4106677/pramac-pmd5050s-autostart/enclosure/README.md

# Корпус для друку (ABS)

Корпус для плати v5: **основа + кришка з «юбкою» + червона вставка з логотипом**. Заокруглені кути й фаски, кайма: на верху стінок основи є уступ, а кришка має юбку, що накриває його, тому бокові стінки кришки й основи збігаються врівень. Кріплення на стіну вушками, кришка на 4 гвинтах M3 у латунні вставки, червона вставка **без гвинтів, на клею**. Усі розміри параметричні.

| Файл | Призначення |
|---|---|
| `base.stl`, `lid.stl`, `cover.stl`, `ear.stl` | готові моделі для друку (вухо `ear.stl` друкується **4 рази**, окремо від основи) |
| `fusion_enclosure.py` | **скрипт Fusion**: створює параметричну модель (User Parameters + ескізи з розмірами) |
| `enclosure.py` | той самий корпус на Python (manifold3d), з якого зроблено STL |
| `fusion_pcb_assembly.py` | **скрипт Fusion**: додає в модель плату v5 з компонентами, латунні вставки й гвинти M3 і фарбує все в реальні кольори |
| `pramac-logo-vector.svg`, `svgpath.py` | логотип і невеликий SVG-парсер, що вставляє його в модель вставки |
| `render.py` | прості рендери (`iso_closed.png`, `iso_all.png`, `iso_base.png`, `front.png`) |

## Габарити
- Зовнішні розміри **112,3 × 118,6 × 50,6 мм** (без вух основа 112,3 мм завширшки, із вухами 144,3 мм), кришка 4 мм + юбка 6 мм, вставка 2 мм (врівень з кришкою). Стінки 3 мм, радіус кутів 7 мм, фаска 1,2 мм.
- Усередині плата 93,3 × 82,1 мм на трьох стійках (6 мм) у місцях її отворів М3 і ще на **шести опорних стійках** Ø5 без гвинтів, а також на **вузьких полицях** по краях (див. нижче). Над платою вільно **40 мм** (конденсатори 4700 мкФ мають 36 мм), під платою 6 мм (виводи 3,5 мм).
- Під платою (внизу при настінному положенні) вільна зона **24 мм** для проводів до клем.
- Поля навколо плати 6,5 мм, щоб вмістити стійки кришки по кутах.

## Що в корпусі
- **Вставка без гвинтів і наскрізне вікно:** вирізу в кришці дано сходинку: зверху гніздо під вставку (100,5 × 37,6 мм, глибина 2 мм), нижче **наскрізне вікно**, менше за вставку на 3 мм з кожного боку. Вставка 100 × 37 × 2 мм лягає врівень і **приклеюється до сходинки** по периметру (3 мм завширшки, близько 800 мм² склеювання), зазор 0,25 мм по боках лишає місце для клею. Кришка й вставка друкуються **лицем на столі**. Клеїти зручно, поклавши кришку лицем угору: вставку кладуть у гніздо, на сходинку (зі сторони вікна) наносять краплі ціанакрилату або ацетонового ABS-клею й притискають. По центру вставки знак «небезпечна напруга». Логотип **Pramac** (з SVG, 40 мм заввишки) вирізано на **основній кришці**, по центру вільної ділянки над вставкою.
- **Логотип і знак втоплені на 0,05 мм** (параметр `inlay`), тож їх зручно розмалювати іншим кольором: фарба лягає в заглиблення, зайве знімається з поверхні.
- **Підтримка плати:** плата тримається на 3 гвинтах, тому додано 6 опорних стійок Ø5 мм (у вільних місцях, відстань до виводів і перехідних не менше 5,6 мм), 6 полиць, що заходять під край плати на 1,5 мм і **напрямні ребра** з зазором 0,4 мм до краю плати (піднімаються на 2 мм над платою). Плату просто кладуть у «кишеню», гвинти фіксують її. Полиці й ребра розставлено, щоб не зачіпати жодної площадки.
- **Три овальні отвори під дроти в нижній стінці**, кожен заввишки 8 мм (`wire_slot_h`), із фаскою 1 мм зовні та 0,5 мм усередині:
  - 12 В: J1, J4, J5, завдовжки 37 мм;
  - 230 В: CONTACTOR, 13 мм. Він окремий, щоб розділити 230 В і слаботочку;
  - сигнали: TAHO/REMOTE, 18 мм.

  Отвори стоять на висоті затискачів клем (`wire_slot_z`), тож кожен дріт іде до своєї клеми прямо. У 8 мм проходять два дроти до 4 мм² або 2-жильний кабель діаметром до 7,5 мм. Герметичності немає, як і задумано. `enclosure.py` і STL досі мають старі щілини 22 мм.
- **Шість вентиляційних щілин** 2 × 24 мм у верхній стінці.
- **Чотири знімні вушка** для кріплення на стіну (Ø5,2 мм), **без гвинтів**. Кому не треба, той їх не ставить. Вухо друкується плоско й має язичок у формі **трапеції** (12 мм завдовжки, звужується до кінця), який вставляється збоку у відповідну трапецієвидну виїмку під дном основи. Виїмка звужується трохи сильніше за язичок, тому в кінці він заклинюється (самозатискний клин). Оскільки вуха стоять із двох боків, основа не може зсунутись убік. Ні гвинтів, ні гайок, у порожнині нічого не додано, плату й компоненти вуха не зачіпають.
- Отвору під USB немає.

## Що купити
- 4+3 = **7 латунних вставок M3** (під гарячу вставку): 4 в кутових стійках, 3 у стійках плати (отвір Ø4,2 мм). Опорні стійки без вставок.
- Гвинти M3: плата 3× по 6–8 мм (довші до 9 мм), кришка 4× по 10 мм і довші (утоплені в заглиблення). **Під вставками є вільний канал Ø3,4 мм** до висоти 1,2 мм над стіною: у кутових стійках він завглибшки майже на всю висоту (гвинти кришки можуть бути завдовжки до ~50 мм), у стійках плати під вставкою ще близько 3,8 мм (разом із платою гвинт до ~9 мм). Дно каналу не наскрізне, тому до стіни основа прилягає гладко.
- Клей для вставки: ціанакрилат (для ABS), або ABS-«клей» з ацетону.
- Для кріплення на стіну (якщо потрібні вуха): 4 шурупи/дюбелі під отвір 5,2 мм.

## Друк
- **ABS**, шар 0,2, 4 периметри (1,6 мм), заповнення 25–30 %, підігрів 100 °C+, борт (brim) проти відшарування. Потрібен стіл не менше **150 × 120 мм**.
- **Основа:** дном на стіл (відкритою стороною вгору). Опор не треба: отвори під дроти мають круглий верх 8 мм, вентиляційні щілини вузькі. **Кришка:** лицем (зовнішньою стороною) на стіл, юбка вгору; сходинка під вікном це міст 3 мм над порожнім гніздом, ABS його витримує без опор. **Вухо:** плоско, усе лежить на столі. Спершу надрукуйте одне вухо й приміряйте: якщо сидить надто туго або хитається, змініть `tab_wedge` (0,3 мм за замовчуванням; більше це тугіше) або `tab_gap`. **Вставка:** лицем на стіл.
- **Лого й знак:** заглиблення 0,05 мм тонше за шар друку (0,2 мм), тому на друку воно майже не видно, але відчувається пальцем і працює як обмежувач для фарби. Якщо потрібен виразний контур, збільште `inlay` до 0,2–0,4 мм.
- **Багатокольоровий друк:** основа й кришка білі (або будь-який колір), вставка червона. Для кольорового логотипу без фарби збільште `inlay` до 0,2–0,4 мм і залийте заглиблення іншим кольором.
- Вставки: прогріти паяльником із насадкою до заглиблення врівень, Ø отвору 4,2 мм.

## Fusion
1. UTILITIES → ADD-INS → Scripts and Add-Ins (Shift+S) → «+» → `fusion_enclosure.py` → Run.
2. З'являться тіла **Base, Lid, Cover** і параметри (Modify → Change Parameters): `pcb_w`, `margin_side`, `gutter`, `wall`, `comp_h` та інші. Зміна параметра перебудовує модель по таймлайну.
3. Позиції отворів плати, щілин, опорних стійок і полиць заведені списками `PCB_HOLES`, `WIRE_SLOTS`, `SUPPORTS`, `LEDGES_*` на початку скрипта (координати від лівого/верхнього краю плати). Логотип скрипт бере з `pramac-logo-vector.svg` поруч зі скриптом (розмір `logo_h`, центрується автоматично).
4. Плата й кріплення: у вже побудованій моделі запустіть `fusion_pcb_assembly.py`. Положення плати й отворів він бере з параметрів і ескізів корпусу, а тіла додає групами (Base Feature `PCB asm: …` у таймлайні). У документі Part Design не буває підкомпонентів, тож усе лежить тілами в корені. Повторний запуск замінює ці групи. Кольори:
   - корпус: білий ABS;
   - вставка й логотип: червоні (#C01717);
   - знак на вставці: білий;
   - плата: зелена;
   - реле: сині;
   - клеми: зелені;
   - резистори: кольорові смуги за номіналом;
   - гвинти: нержавійка, ISO 7380 M3×8;
   - вставки: латунні.

   Скрипт моделює плату **v5.1**: ESP32 на 2 мм вище, ніж на v5, а **іоністор SC1** (JEC SMD05R5S0001DARZ, 1 Ф 5,5 В, овал 16 × 8 × 14 мм) стоїть прямо на платі, на власному посадковому місці між ESP32 і реле K1/K2. Зазори близько 1 мм до гнізд ESP32 і до реле. Друкована підставка під іоністор, яка була для v5, більше не потрібна. Опорну стійку під гніздами ESP32 зсунуто в (85, 24), щоб не впиралась у пайку гнізд.

⚠️ Скрипт написано за документацією Fusion API **без запуску у Fusion** (на цьому Mac його нема), STL натомість перевірені. Основна геометрія створюється першою, а косметика (заокруглення кутів, фаски, знаки, логотип з SVG, напрямні ребра) йде як «необов'язкові» кроки: якщо якийсь не вдасться, скрипт піде далі й наприкінці перелічить пропущене. Якщо впаде основний крок, він покаже назву кроку й помилку. Надішліть мені текст, я виправлю. Найризикованіший крок: імпорт SVG (`importSVG`) і відбір контурів букв без «острівців» (внутрішніх частин літер P, R, A). Якщо він не вдасться, перемістіть SVG вручну (Insert → Insert SVG) і вирізайте на 0,05 мм, або використовуйте готовий `cover.stl`.

## Перевірка перед друком
Роздрукуйте `fit_check_1to1.pdf` плати й приміряйте до отворів (3 стійки, відстані до клем). Висоту ESP32 з колодками (~22–25 мм над платою) і конденсаторів 36 мм перевірте реальними деталями: якщо щось вище 40 мм, збільшіть `comp_h`.
