4106677/pramac-pmd5050s-autostart/hardware/v6/README.md

# Плата v6

Плата під заводську збірку JLCPCB (PCBA): майже все SMD, решту (реле, клеми, модуль AC-DC, мережевий запобіжник, варистор) завод теж паяє, сервісом THT. Допаювати нічого не треба.

| Файл | Що це |
|---|---|
| `pramac_v6_schematic.pdf` | схема для перегляду |
| `pramac_v6.kicad_sch`, `pramac_v6.kicad_pro`, `pramac_v6.kicad_sym`, `sym-lib-table` | проєкт KiCad 10 (схема + власні символи CN3767 і AO4421) |
| `pramac_v6_bom.csv` | BOM у форматі JLCPCB (Comment, Designator, Footprint, LCSC) |
| `gen_schematic.py`, `charger.py`, `parts.py`, `kisch.py` | генератор схеми: `python3 gen_schematic.py` |
| `pramac_v6.kicad_pcb`, `pramac_v6.kicad_dru` | плата 125 × 100 мм, 2 шари, і правило зазору 2,5 мм для 230 В |
| `pramac_v6_gerbers.zip` | гербери + свердління для JLCPCB |
| `pramac_v6_bom.csv`, `pramac_v6_cpl.csv` | BOM і файл розміщення (CPL) для заводської збірки |
| `pcb-top.png`, `pcb-bottom.png`, `drc.rpt` | рендери і звіт DRC |
| `gen_pcb.py`, `pramac_v6.dsn`, `pramac_v6.ses` | генератор плати: `gen_pcb.py place` → Freerouting (`.dsn` → `.ses`) → `gen_pcb.py route` → `gen_pcb.py export` |

## Що змінилось порівняно з v5.1
- **ESP32-S3-MINI-1U-N8** розпаяний на платі (15,4 × 15,4 мм), роз'єм U.FL під зовнішню антену: кабель U.FL → SMA на стінці корпусу. Прошивка й лог по USB-C (USB вбудований у чип), кнопки BOOT і RESET.
- **Живлення без іоністора:** два маленькі перетворювачі прямо від АКБ. AP63203 дає 3,3 В для ESP32 і працює від 3,8 В. AP63205 дає окремі 5 В для котушок реле. Обидва мають режим LDO: коли АКБ під час прокрутки падає нижче 5 В, вихід 5 В іде слідом за входом, а реле SRD-05 тримаються аж до ~2 В на котушці. Тому **іоністор більше не потрібен**.
- **Реле** ті самі Songle SRD-05VDC-SL-C. Ключі AO3400A, діоди на котушках, світлодіод стану на кожному реле.
- **Четверте реле K4 AUX** для підігрівача перед пуском або соленоїда декомпресії. COM на шині АКБ, як у ACC і START, вихід на окремий клемник J8 (AUX, GND).
- **Зарядка АКБ від 230 В:** модуль Mean Well IRM-20-24 → зарядник CN3767. Заряд 14,8 В, підтримка 13,55 В (задані всередині мікросхеми), струм 1 А. Підходить для звичайних свинцевих і AGM.
- **Детектор мережі:** оптопара LTV-814 на вході 230 В.
- **DIP-перемикач на 4 позиції** для вибору режиму, **4 кріплення M3 по кутах**, знімні клемники 5,08 мм.

## Живлення
`BATTERY+` → самовідновлюваний запобіжник 2 А (PTC) → `VBF` (TVS SMBJ18A, вихід зарядника, вимір напруги АКБ) → SS54 → `VIN12` (470 мкФ).
Від `VIN12` живляться AP63203 (3,3 В, ESP32) і AP63205 (`V5`, тільки котушки реле й світлодіоди реле).
Від USB: `VBUS` → SS34 → `VIN12`, тобто ESP32 можна прошити без 12 В.
Шина `VBAT` (до запобіжника) іде на COM реле ACC і START. На дроті від АКБ, як і раніше, потрібен зовнішній запобіжник ~15 А.

## Зарядник
- **Живлення і перемикач:** `V24` з модуля через P-MOSFET Q20. Ним керує ESP32 (`CHG_EN`): HIGH, або коли ESP32 не працює, зарядка йде; LOW — вимкнена. Прошивка вимикає зарядку на час прокрутки стартера і коли DIP2 вимкнений.
- **Струм:** 0,12 В / R66 = 1 А при R66 = 0,12 Ом. Модуль на 20 Вт має запас: зарядник бере близько 17 Вт.
- **Захист модуля від перевантаження:** дільник MPPT (150k/10k). Якщо модуль просяде нижче ~19 В, зарядник сам зменшить струм.
- **Стан:** `CHG_STAT` (заряджається) і `CHG_DONE` (заряджено) йдуть на ESP32 і на два світлодіоди.

## Піни ESP32-S3
| GPIO | Сигнал | GPIO | Сигнал |
|---|---|---|---|
| IO1 | напруга АКБ (АЦП, дільник 100k/22k) | IO9 | світлодіод STATUS |
| IO2 | CHG_DONE | IO10 / IO11 / IO12 | реле K1 ACC / K2 START / K3 контактор |
| | | IO21 | реле K4 AUX |
| IO4 | TAHO (LM393) | IO13–IO16 | DIP1–DIP4 |
| IO5 | REMOTE (сухий контакт між двома клемами REMOTE) | IO17, IO18 | резервна гребінка J7 |
| IO6 | MAINS_OK (мережа є = LOW) | IO19 / IO20 | USB D− / D+ |
| IO7 | CHG_EN | IO0 / EN | BOOT / RESET |
| IO8 | CHG_STAT | | |

## DIP-перемикач
1. Режим: OFF — запуск за сигналом REMOTE; ON — запуск, коли пропала мережа.
2. Зарядка дозволена.
3. Затримка запуску: 10 с або 60 с.
4. AUX: OFF — K4 працює як підігрів (вмикається на N секунд до прокрутки), ON — як декомпресія (тримається під час прокрутки).

## Роз'єми (знімні клемники 5,08 мм)
| Роз'єм | Контакти |
|---|---|
| J1 | AC IN: L, N |
| J2 | CONTACTOR: COM, NO (сухі контакти, 230 В) |
| J3 | BATTERY: +, − |
| J4 | ACC, START |
| J5 | TAHO; REMOTE, REMOTE (два контакти під сухий контакт або кнопку, полярність не важлива) |
| J8 | AUX: вихід K4 (+12 В з АКБ), GND |

Плагіни до клемників (WJ2EDGK, 5 × 2P і 1 × 3P) JLCPCB надсилає разом із замовленням окремими деталями.

**Навантаження на AUX.** Контакт реле SRD розрахований на 10 А. Свічки розжарювання і соленоїд декомпресії в момент втягування часто беруть більше. Тому для них ставте зовнішнє автомобільне реле на 30–40 А: його котушку підключити до J8 (AUX і GND), а силові контакти — напряму від АКБ через свій запобіжник. Слабке навантаження до ~8 А можна живити від J8 напряму.

## Плата
- **Розмір і кріплення:** 125 × 100 мм, 2 шари, 4 отвори M3 по кутах (за 4 мм від країв).
- **Зона 230 В ліворуч:** модуль AC-DC, запобіжник, варистор, реле контактора K3, детектор мережі (три резистори й оптопара під модулем AC-DC), клемники AC IN і CONTACTOR. Полігону землі там немає. Правило DRC тримає ≥ 2,5 мм від будь-якої мережевої міді до низьковольтної. Оптопара й модуль AC-DC стоять на межі зон.
- **Реле K4, K1, K2** стоять в один ряд на місці, що звільнилось у нижньому лівому куті. Їхні COM з'єднує одна шина АКБ.
- **Сильнострумові ланцюги** розведені вручну по нижньому шару. Шина АКБ від J3 до COM реле і виходи ACC/START/AUX мають ширину 3–4 мм.
- **Решта** розведена Freerouting. Земля: полігони з обох боків, перехідні отвори біля кожного SMD-виводу GND і зшивання сіткою 5 мм.
- **DRC:** 0 помилок, усі зв'язки з'єднані. Лишилось 3 попередження про шовкографію; на виводах завод її сам обрізає.
- **Розташування:** ESP32 угорі праворуч (роз'єм U.FL для кабелю до SMA на корпусі), USB-C на правому краю, кнопки RESET/BOOT під модулем, клемники вздовж нижнього краю.

## Замовлення на JLCPCB
- **PCB:** 2 шари, 1,6 мм, мідь **2 oz** (струм реле до 10 А), HASL без свинцю, файл `pramac_v6_gerbers.zip`.
- **Збірка:** у PCB Assembly завантажити `pramac_v6_bom.csv` і `pramac_v6_cpl.csv`. Виводні деталі (реле, клемники, IRM-20-24, запобіжник, варистор) завод теж паяє, сервісом THT.
- **Обов'язково перегляньте в превʼю JLCPCB поворот деталей:** у бібліотеки JLC своя орієнтація, і частину кутів (SOT-23, діоди, модуль ESP32, USB-C) зазвичай доводиться підправити там же.
- **Звірте посадкові місця на етапі DFM JLCPCB.** Їх я взяв з бібліотеки KiCad, вони відповідають корпусам у даташитах, але завод це перевіряє окремо:
  - клемники WJ2EDGRC (посадкове місце Phoenix MSTBA 5,08);
  - оптопара LTV-814S (SMDIP-4);
  - DIP-перемикач.
- **Завод розпаює все**, включно з резервною гребінкою J7 (PZ254V-11-04P, C2691448). TP1–TP3 — це просто мідні площадки UART без деталі, а отвори H1–H4 — кріплення. Плагіни клемників приходять окремо й просто вставляються в гнізда, паяти їх не треба.

## Що далі
1. ~~Перевірка схеми~~ (погоджено).
2. ~~Плата~~ (готова, див. вище).
3. Корпус: SMA, нові роз'єми.
4. Прошивка: ESP32-S3, режим «пропала мережа», зарядка, реле AUX.
