4106677/pramac-pmd5050s-autostart/docs/lid_layout.png

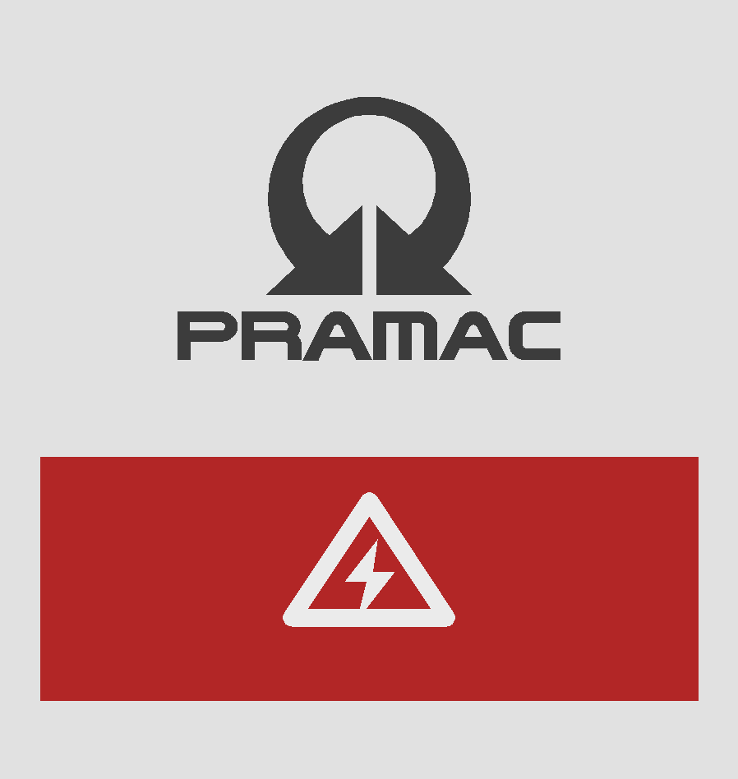
docs/lid_layout.png
