4106677/pramac-pmd5050s-autostart/enclosure/front.png

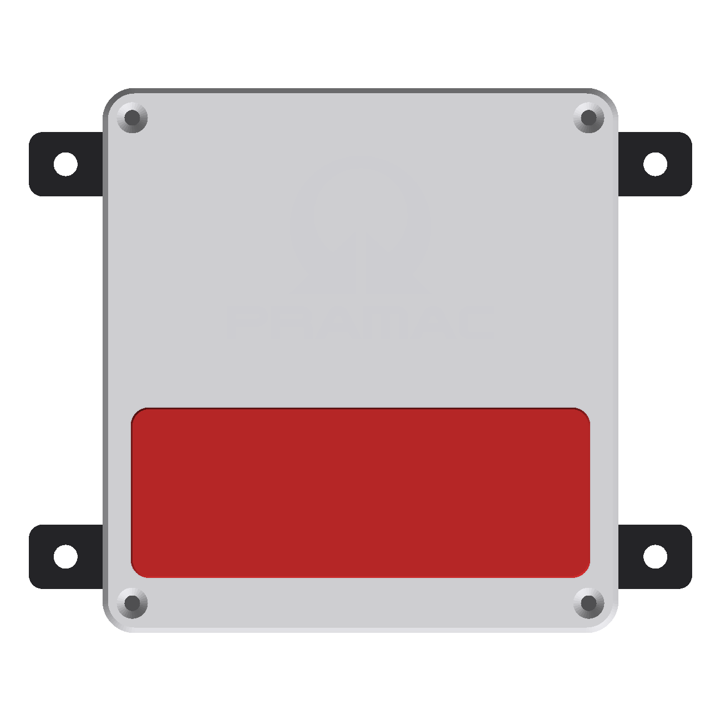
enclosure/front.png
