4106677/pramac-pmd5050s-autostart/enclosure/iso_all.png

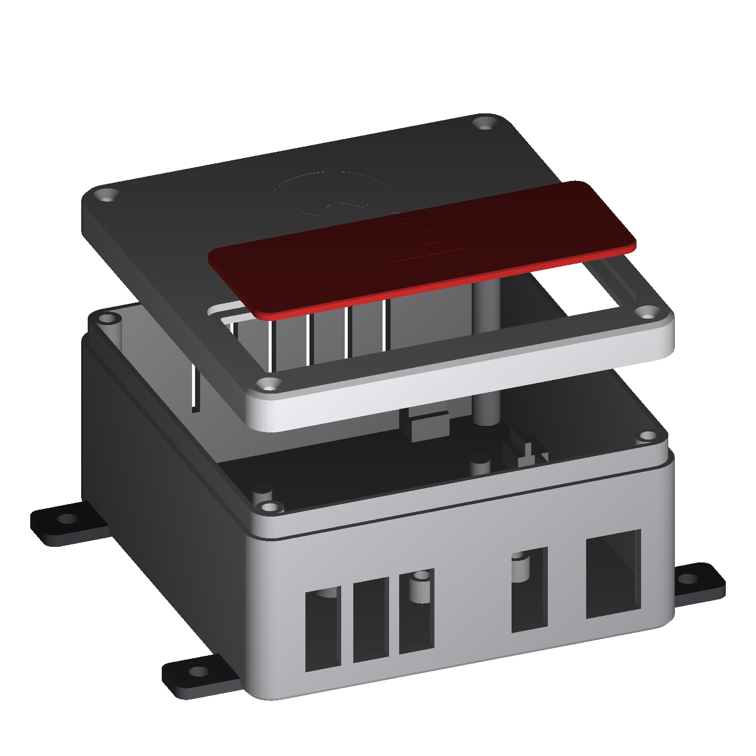
enclosure/iso_all.png
