4106677/pramac-pmd5050s-autostart/enclosure/iso_base.png

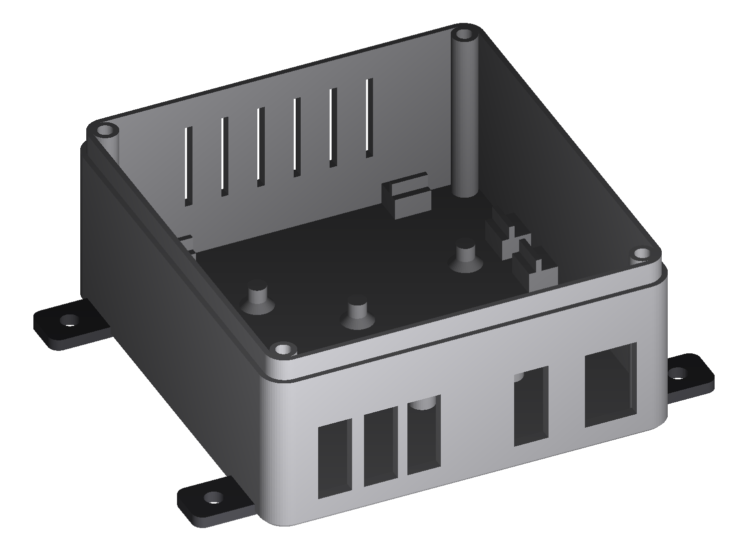
enclosure/iso_base.png
