4106677/pramac-pmd5050s-autostart/enclosure/iso_ear.png

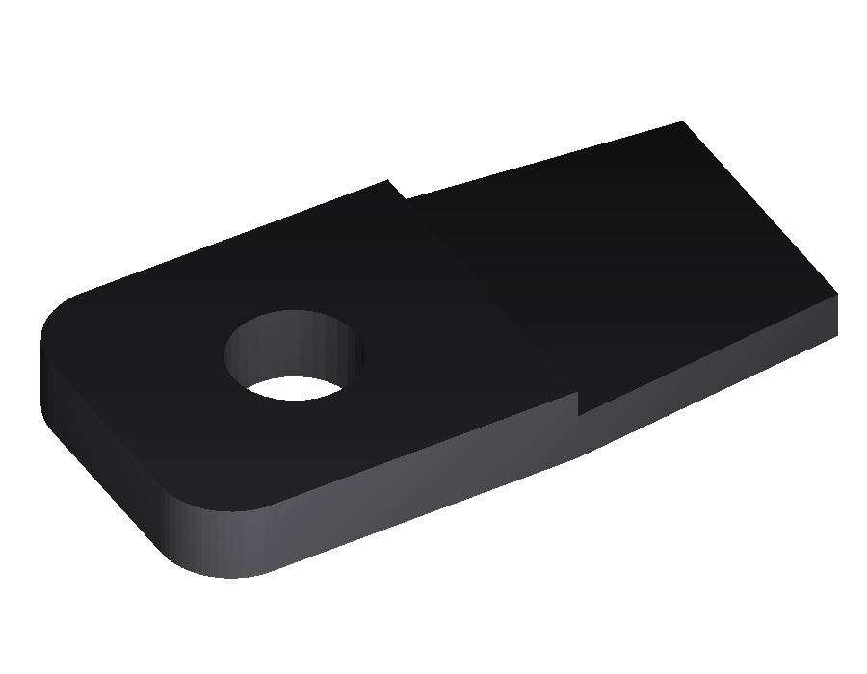
enclosure/iso_ear.png
