4106677/pramac-pmd5050s-autostart/hardware/v6/pcb-bottom.png

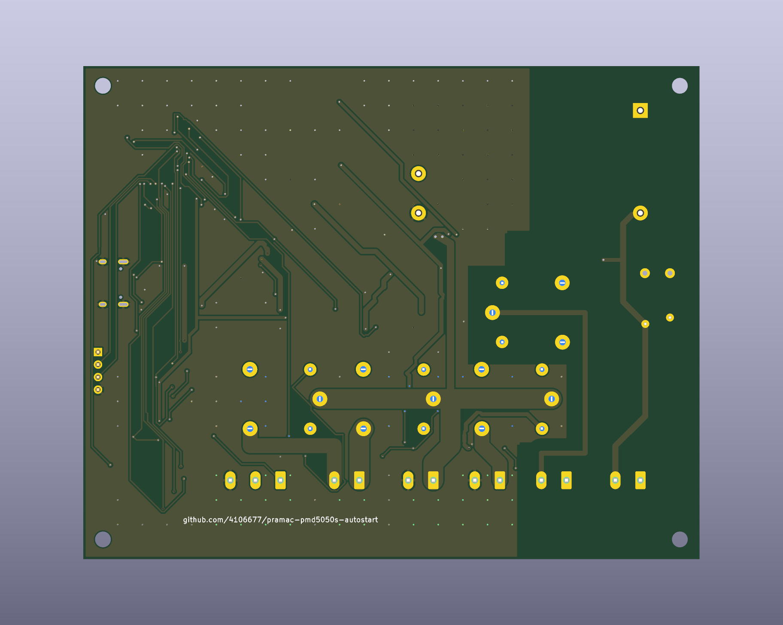
hardware/v6/pcb-bottom.png
