4106677/pramac-pmd5050s-autostart/hardware/v6/pcb-top.png

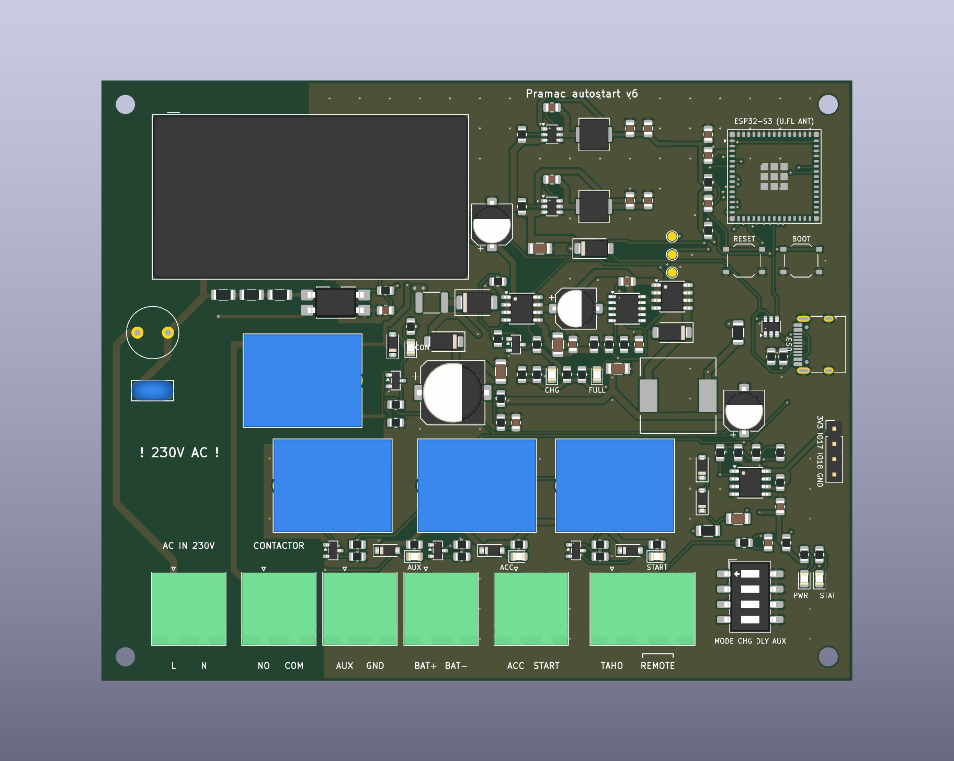
hardware/v6/pcb-top.png
