4106677/pramac-pmd5050s-autostart/hardware/BOM.md

# BOM плати v5.1 (93,2 × 82 мм)

Усі резистори — 0,25 Вт виводні (DIN0207), стоять вертикально. Діоди й TO-92 також вертикально.

| # | Ref | Кількість | Компонент | Примітка |
|---|---|---|---|---|
| 1 | J1, J4, J5, J6 | 4 | Клемник Degson DG128-5.0-**02P**, крок 5,0 мм | отвір Ø1,4; дріт входить з боку краю плати |
| 2 | J2 | 1 | Клемник Degson DG128-5.0-**03P** | TAHO / REMOTE (2 контакти) |
| 3 | F1 | 1 | Запобіжник KLS5-102-5RT-020H, 2 А повільний, радіальний D8,5×7,2, крок 5,08 | без тримача |
| 4 | D3 | 1 | TVS P6KE36A (рекомендовано P6KE20A) | катод на +, до D1 |
| 5 | D1, D2 | 2 | Діод Шотткі 1N5821 | |
| 6 | C1, C2 | 2 | 4700 мкФ 25 В, 18×36 мм | |
| 7 | RM1 | 1 | Favotek RM20S-050, SIP-3, 5 В 2 А | 1 +VIN, 2 GND, 3 +VOUT (на платі підписано IN / GND / OUT); корпус з боку D2 |
| 8 | SC1 | 1 | Іоністор 1 Ф 5,5 В JEC SMD05R5S0001DARZ (овал 16 × 8 × 14 мм, крок виводів 11,8) | стоїть на платі на власних виводах, «+» ліворуч (біля RM1, позначено «+») |
| 9 | K1, K2, K3 | 3 | Реле SRD-05VDC-SL-**A** (10 А, лише NO); SL-C теж підходить | pad 1 COM, pad 3 NO |
| 10 | Q1, Q2, Q3 | 3 | Транзистор BC337 (TO-92, C-B-E) | |
| 11 | D6, D7, D8 | 3 | Діод 1N4148 | діод котушки |
| 12 | Rb1, Rb2, Rg3, R6 | 4 | Резистор 1 кОм | |
| 13 | Rp1, Rp2, Rp3, Rb3, Rv1, Rv2 | 6 | Резистор 10 кОм | |
| 14 | R4 | 1 | Резистор 100 кОм | |
| 15 | R5 | 1 | Резистор 4,7 кОм | |
| 16 | R1 | 1 | Резистор 22 кОм | |
| 17 | D4, D5 | 2 | Стабілітрон BZX55C5V1 | |
| 18 | C3 | 1 | 10 мкФ 16 В неполярний, 5×11 мм | |
| 19 | C5, C6 | 2 | Конденсатор 100 нФ 50 В X7R, 0805 | |
| 20 | U3 | 1 | LM393 DIP-8 | **впаюється без тримача** |
| 21 | U1A, U1B | 2 | Гніздова колодка 1×15, крок 2,54 мм, **пряма** (KLS1-208-1-15-**S**; PBS-15**R** кутова — не підходить), висота ~8,5 мм | |
| 22 | U1 | 1 | ESP32 DevKit V1 30-pin | вставляється в колодки |
| 23 | J3 | 1 | Штирьовий хедер 1×4, крок 2,54 | резервний роз'єм: 5V, D27 (IN1), D13 (IN2), GND |
| 24 | H1–H4 | 4 | Гвинти M3 + стійки | |

Для PCBWay: 2 шари, 1,6 мм, мідь **2 oz** (шина 10 А), HASL без свинцю.
Контакти K3 (клема J6 CONTACTOR) — сухі COM/NO під котушку контактора 230 В. Розведені із зазором ≥ 2,5 мм (правило в `pramac_carrier.kicad_dru`). Для мережевої напруги це не сертифіковане рішення: перевірте самостійно.

**Компонування v5:** ESP32 лежить горизонтально (антена ліворуч, USB праворуч, USB і антена виступають за край/зону заборони міді). Під модулем (висота зазору ~8,5 мм) стоять лише низькі деталі: транзистори й резистори драйверів K1/K2. Високі деталі (C1, C2, діоди, RM20S, C3, реле, клеми) розташовані поза модулем. Під антеною (мітка ANTENNA KEEP-OUT) немає міді на жодному шарі.
