4106677/pramac-pmd5050s-autostart/hardware/v6/pramac_v6_bom.csv

Comment | Designator | Footprint | LCSC | Qty
470u 35V | C1 | CP_Elec_10x10.5 | C2836436 | 1
10u 50V X5R | C2,C13,C61,C66 | C_1206_3216Metric | C13585 | 4
100n 50V X7R | C3,C4,C7,C10,C31,C32,C62,C63 | C_0805_2012Metric | C49678 | 8
22u 10V X5R | C5,C6,C8,C9,C12 | C_0805_2012Metric | C380338 | 5
1u 25V X7R | C11,C41 | C_0805_2012Metric | C89190 | 2
10u 25V X7R | C30 | C_1206_3216Metric | C70462 | 1
100u 35V | C40,C60,C65 | CP_Elec_6.3x7.7 | C2836442 | 3
220n 50V X7R | C64 | C_0805_2012Metric | C5378 | 1
SMBJ18A | D1 | D_SMB | C353379 | 1
SS54 | D2,D22 | D_SMA | C22452 | 2
SS34 | D4 | D_SMA | C8678 | 1
1N4148W | D10,D11,D12,D16 | D_SOD-123 | C81598 | 4
LED ACC | D13 | LED_0805_2012Metric | C84256 | 1
LED START | D14 | LED_0805_2012Metric | C84256 | 1
LED CONTACTOR | D15 | LED_0805_2012Metric | C84256 | 1
LED AUX | D17 | LED_0805_2012Metric | C84256 | 1
BZT52C5V1 | D20,D21 | D_SOD-123 | C2117 | 2
LED CHARGING | D23 | LED_0805_2012Metric | C84256 | 1
LED CHARGED | D24 | LED_0805_2012Metric | C2297 | 1
LED POWER | D30 | LED_0805_2012Metric | C2297 | 1
LED STATUS | D31 | LED_0805_2012Metric | C2297 | 1
PTC 2A hold 1812 | F1 | Fuse_1812_4532Metric | C434887 | 1
T1A 250VAC TR5 | F2 | Fuse_Littelfuse_372_D8.50mm | C142808 | 1
AC IN 230V (L N) | J1 | PhoenixContact_MSTBA_2,5_2-G-5,08_1x02_P5.08mm_Horizontal | C3697 | 1
CONTACTOR (NO COM) | J2 | PhoenixContact_MSTBA_2,5_2-G-5,08_1x02_P5.08mm_Horizontal | C3697 | 1
BATTERY (+ -) | J3 | PhoenixContact_MSTBA_2,5_2-G-5,08_1x02_P5.08mm_Horizontal | C3697 | 1
ACC START | J4 | PhoenixContact_MSTBA_2,5_2-G-5,08_1x02_P5.08mm_Horizontal | C3697 | 1
TAHO REMOTE REMOTE | J5 | PhoenixContact_MSTBA_2,5_3-G-5,08_1x03_P5.08mm_Horizontal | C8377 | 1
TYPE-C-31-M-12 | J6 | USB_C_Receptacle_HRO_TYPE-C-31-M-12 | C165948 | 1
SPARE 3V3 IO17 IO18 GND | J7 | PinHeader_1x04_P2.54mm_Vertical | C2691448 | 1
AUX (OUT GND) | J8 | PhoenixContact_MSTBA_2,5_2-G-5,08_1x02_P5.08mm_Horizontal | C3697 | 1
SRD-05VDC-SL-C | K1,K2,K3,K4 | Relay_SPDT_SANYOU_SRD_Series_Form_C | C35449 | 4
4.7u 5A FXL0530 | L1,L2 | L_Changjiang_FXL0530 | C177246 | 2
47u 2.5A SMDRI127 | L20 | L_12x12mm_H8mm | C9906 | 1
IRM-20-24 | PS1 | Converter_ACDC_MeanWell_IRM-20-xx_THT | C194964 | 1
AO3400A | Q1,Q2,Q3,Q4,Q22 | SOT-23 | C20917 | 5
AO4421 | Q20,Q21 | SOIC-8_3.9x4.9mm_P1.27mm | C33484 | 2
100k | R1,R3,R8,R11,R13,R15,R17,R34,R62 | R_0805_2012Metric | C149504 | 9
22k | R2 | R_0805_2012Metric | C17560 | 1
10k | R4,R5,R31,R32,R33,R37,R60,R61,R64,R67,R69 | R_0805_2012Metric | C17414 | 11
5k1 | R6,R7 | R_0805_2012Metric | C27834 | 2
100 | R10,R12,R14,R16 | R_0805_2012Metric | C17408 | 4
2k2 | R20,R21,R22,R23 | R_0805_2012Metric | C17520 | 4
22k | R30 | R_1206_3216Metric | C25830 | 1
4k7 | R35 | R_0805_2012Metric | C17673 | 1
1k | R36,R50,R51,R68,R70 | R_0805_2012Metric | C17513 | 5
47k | R40,R41,R42 | R_1206_3216Metric | C25833 | 3
47k | R43 | R_0805_2012Metric | C17713 | 1
150k | R63 | R_0805_2012Metric | C17470 | 1
120 | R65 | R_0805_2012Metric | C17437 | 1
0.12 1% 1206 | R66 | R_1206_3216Metric | C2907346 | 1
07D471K | RV1 | RV_Disc_D7mm_W3.4mm_P5mm | C28756 | 1
RESET | SW1 | SW_Push_1P1T_XKB_TS-1187A | C318884 | 1
BOOT | SW2 | SW_Push_1P1T_XKB_TS-1187A | C318884 | 1
DIP switch 4P | SW3 | SW_DIP_SPSTx04_Slide_6.7x11.72mm_W8.61mm_P2.54mm_LowProfile | C6331176 | 1
ESP32-S3-MINI-1U-N8 | U1 | ESP32-S2-MINI-1U | C2980299 | 1
AP63203WU-7 | U2 | TSOT-23-6 | C780769 | 1
AP63205WU-7 | U3 | TSOT-23-6 | C2071056 | 1
USBLC6-2SC6 | U4 | SOT-23-6 | C7519 | 1
LM393DR2G | U5 | SOIC-8_3.9x4.9mm_P1.27mm | C7955 | 1
LTV-814S-TA1-A | U6 | SMDIP-4_W9.53mm | C108051 | 1
CN3767 | U20 | SSOP-10_3.9x4.9mm_P1.00mm | C81968 | 1
WJ2EDGK-5.08-02P-14-00A (loose, not soldered: plug 2P for J1-J4, J8) |  |  | C71370 | 5
WJ2EDGK-5.08-03P-14-00A (loose, not soldered: plug 3P for J5) |  |  | C71371 | 1
