4106677/pramac-pmd5050s-autostart/enclosure/base.stl

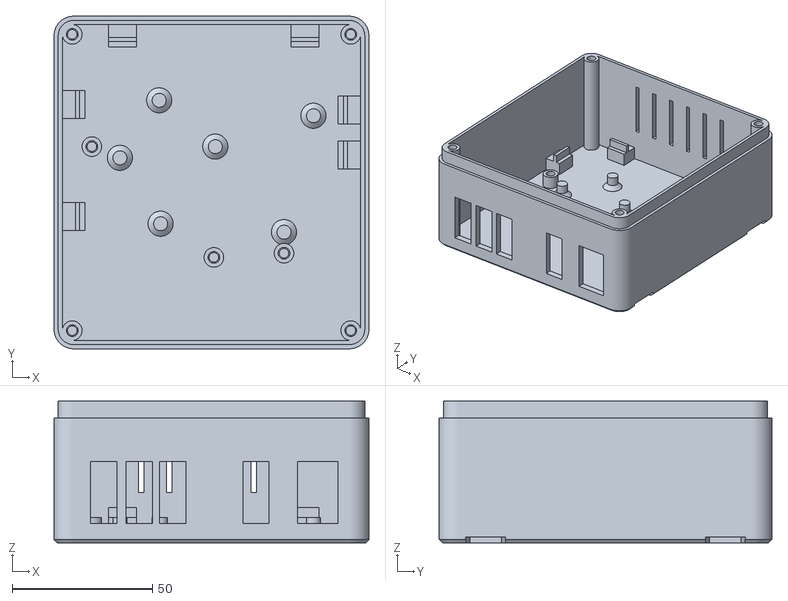
[picture p12: CAD file, 2026-10-22]
enclosure/base.stl
112.3 x 118.6 x 50.6
