4106677/pramac-pmd5050s-autostart/enclosure/ear.stl

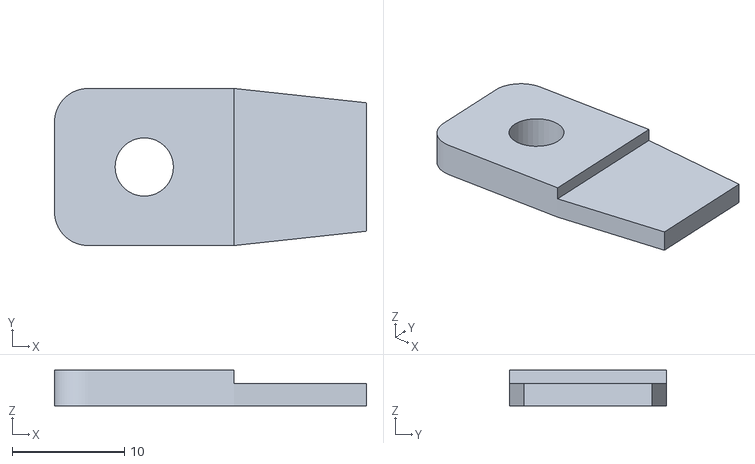
[picture p13: CAD file, 2026-10-22]
enclosure/ear.stl
27.8 x 14.0 x 3.20
