4106677/pramac-pmd5050s-autostart/enclosure/lid.stl

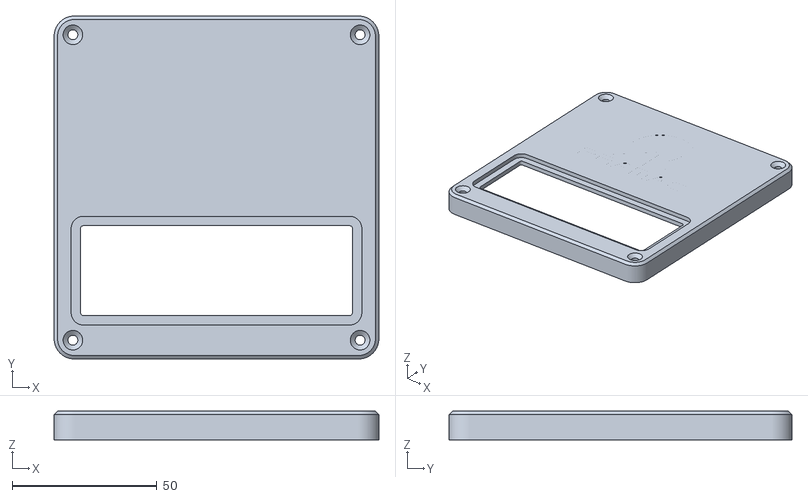
[picture p14: CAD file, 2026-10-22]
enclosure/lid.stl
112.3 x 118.6 x 10.0
