4106677/pramac-pmd5050s-autostart/enclosure/cover.stl

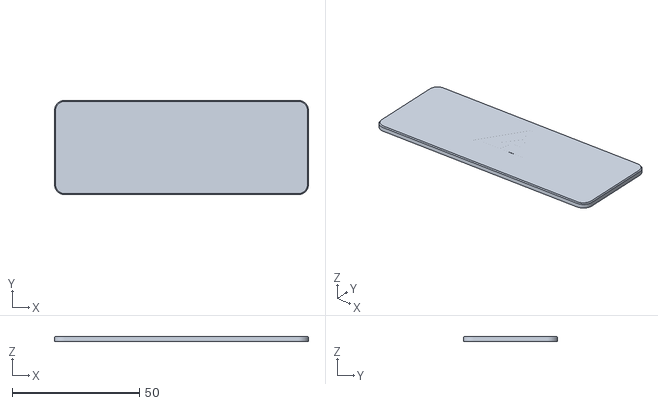
[picture p15: CAD file, 2026-10-22]
enclosure/cover.stl
100.0 x 37.1 x 2.00
