4106677/pramac-pmd5050s-autostart/hardware/v6/pramac_v6_schematic.pdf

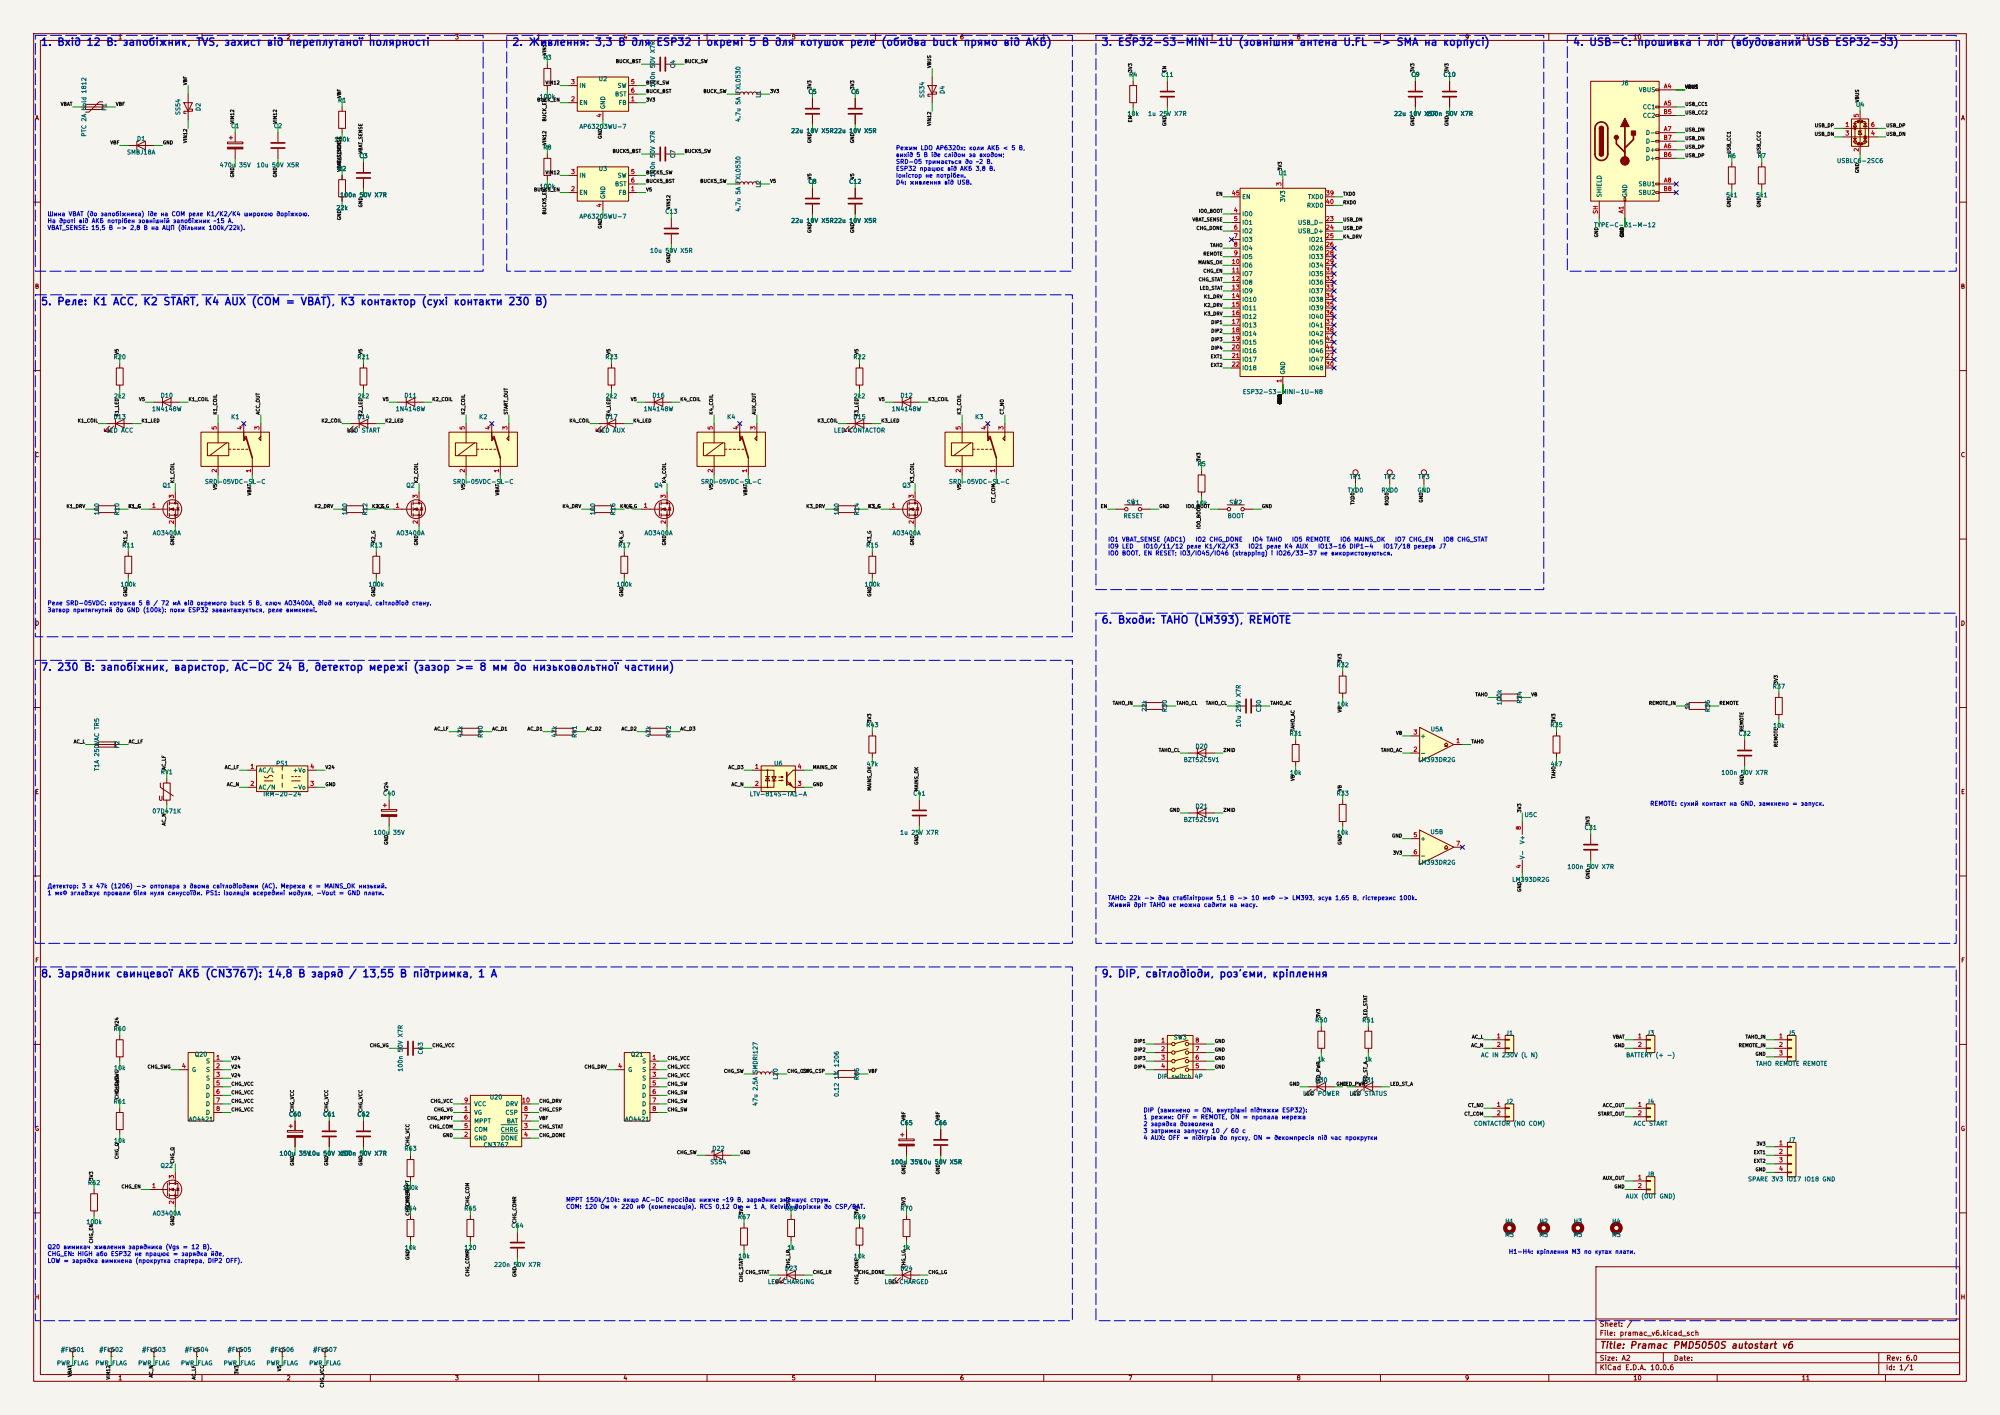
[picture p16: page 1]

Режим LDO AP6320x: коли АКБ < 5 В, вихід 5 В іде слідом за входом; SRD-05 тримається до ~2 В. ESP32 працює від АКБ 3,8 В.

Іоністор не потрібен. D4: живлення від USB. 5. Реле: K1 ACC, K2 START, K4 AUX (COM = VBAT), K3 контактор (сухі контакти 230 В)

IO0 BOOT, EN RESET; IO3/IO45/IO46 (strapping) і IO26/33-37 не використовуються. Шина VBAT (до запобіжника) іде на COM реле K1/K2/K4 широкою доріжкою. На дроті від АКБ потрібен зовнішній запобіжник ~15 А. VBAT_SENSE: 15,5 В -> 2,8 В на АЦП (дільник 100k/22k). Реле SRD-05VDC: котушка 5 В / 72 мА від окремого buck 5 В, ключ AO3400A, діод на котушці, світлодіод стану. Затвор притягнутий до GND (100k): поки ESP32 завантажується, реле вимкнені. 7. 230 В: запобіжник, варистор, AC-DC 24 В, детектор мережі (зазор >= 8 мм до низьковольтної частини)

TAHO: 22k -> два стабілітрони 5,1 В -> 10 мкФ -> LM393, зсув 1,65 В, гістерезис 100k. Живий дріт TAHO не можна садити на масу. 6. Входи: TAHO (LM393), REMOTE

REMOTE: сухий контакт на GND, замкнено = запуск.

FGH
8. Зарядник свинцевої АКБ (CN3767): 14,8 В заряд / 13,55 В підтримка, 1 А

H1-H4: кріплення M3 по кутах плати. DIP (замкнено = ON, внутрішні підтяжки ESP32): 1 режим: OFF = REMOTE, ON = пропала мережа 2 зарядка дозволена 3 затримка запуску 10 / 60 с 4 AUX: OFF = підігрів до пуску, ON = декомпресія під час прокрутки Q20 вимикач живлення зарядника (Vgs = 12 В). CHG_EN: HIGH або ESP32 не працює = зарядка йде, LOW = зарядка вимкнена (прокрутка стартера, DIP2 OFF).

MPPT 150k/10k: якщо AC-DC просідає нижче ~19 В, зарядник зменшує струм. COM: 120 Ом + 220 нФ (компенсація). RCS 0,12 Ом = 1 А, Kelvin-доріжки до CSP/BAT.

Size: A2 | Rev: 6.0
KiCad E.D.A. 10.0.6 | Id: 1/1
