4106677/pramac-pmd5050s-autostart/hardware/fit_check_1to1.pdf

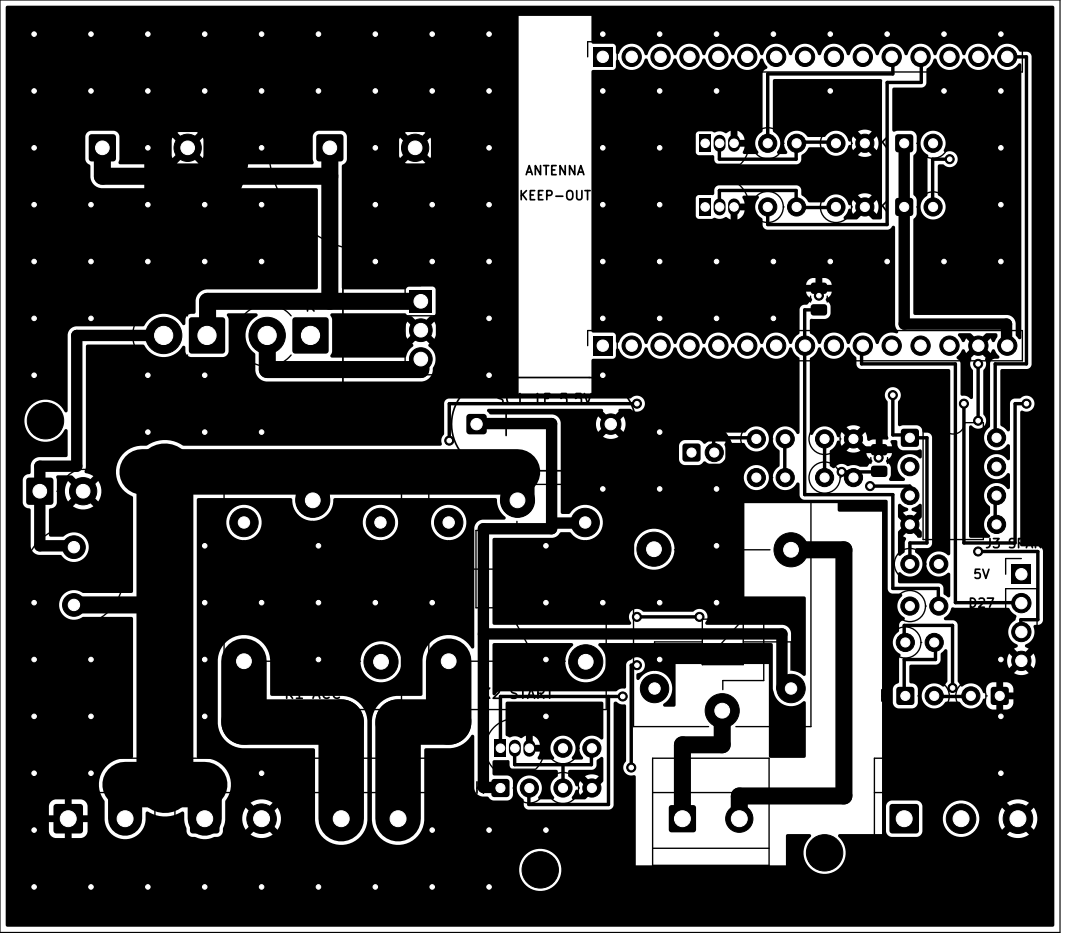
[picture p17: page 1]
