4106677/pramac-pmd5050s-autostart/(list of files, drawings)

Other design files:
hardware/v6/pramac_v6.dsn
