4106677/pramac-pmd5050s-autostart/hardware/v6/pramac_v6.kicad_pcb

## KiCad design hardware/v6/pramac_v6.kicad_pcb (2026-11-12)

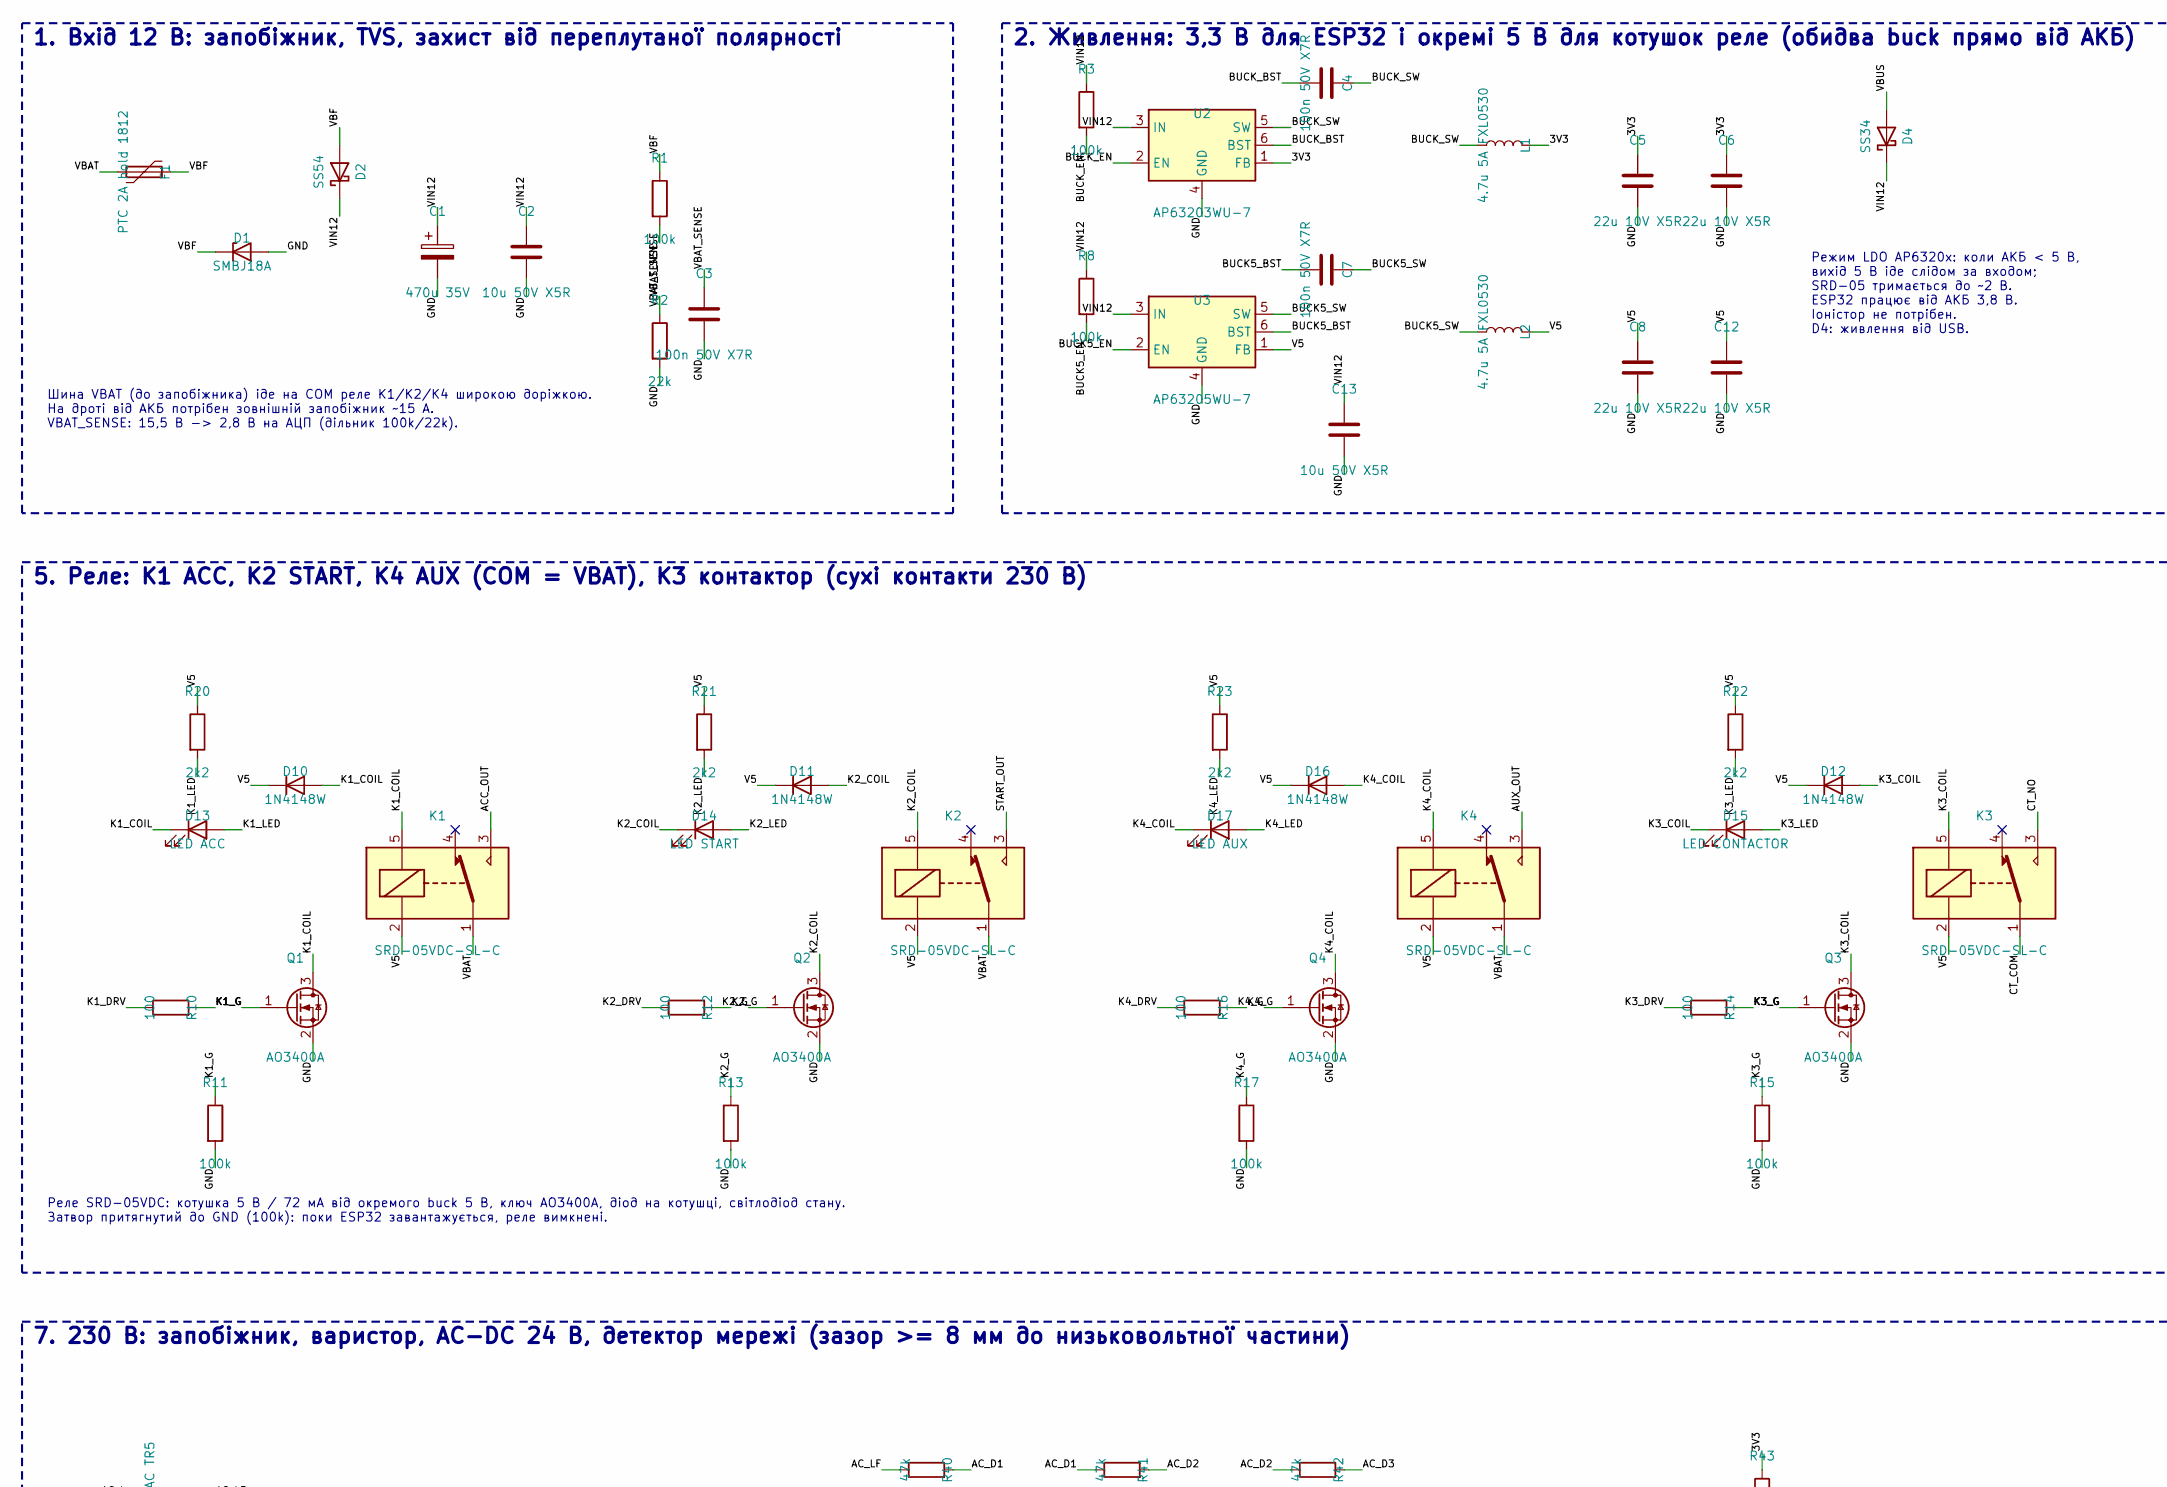
[picture p18: schematic pramac_v6.kicad_sch, Pramac PMD5050S autostart v6, part in row 1, column 1]

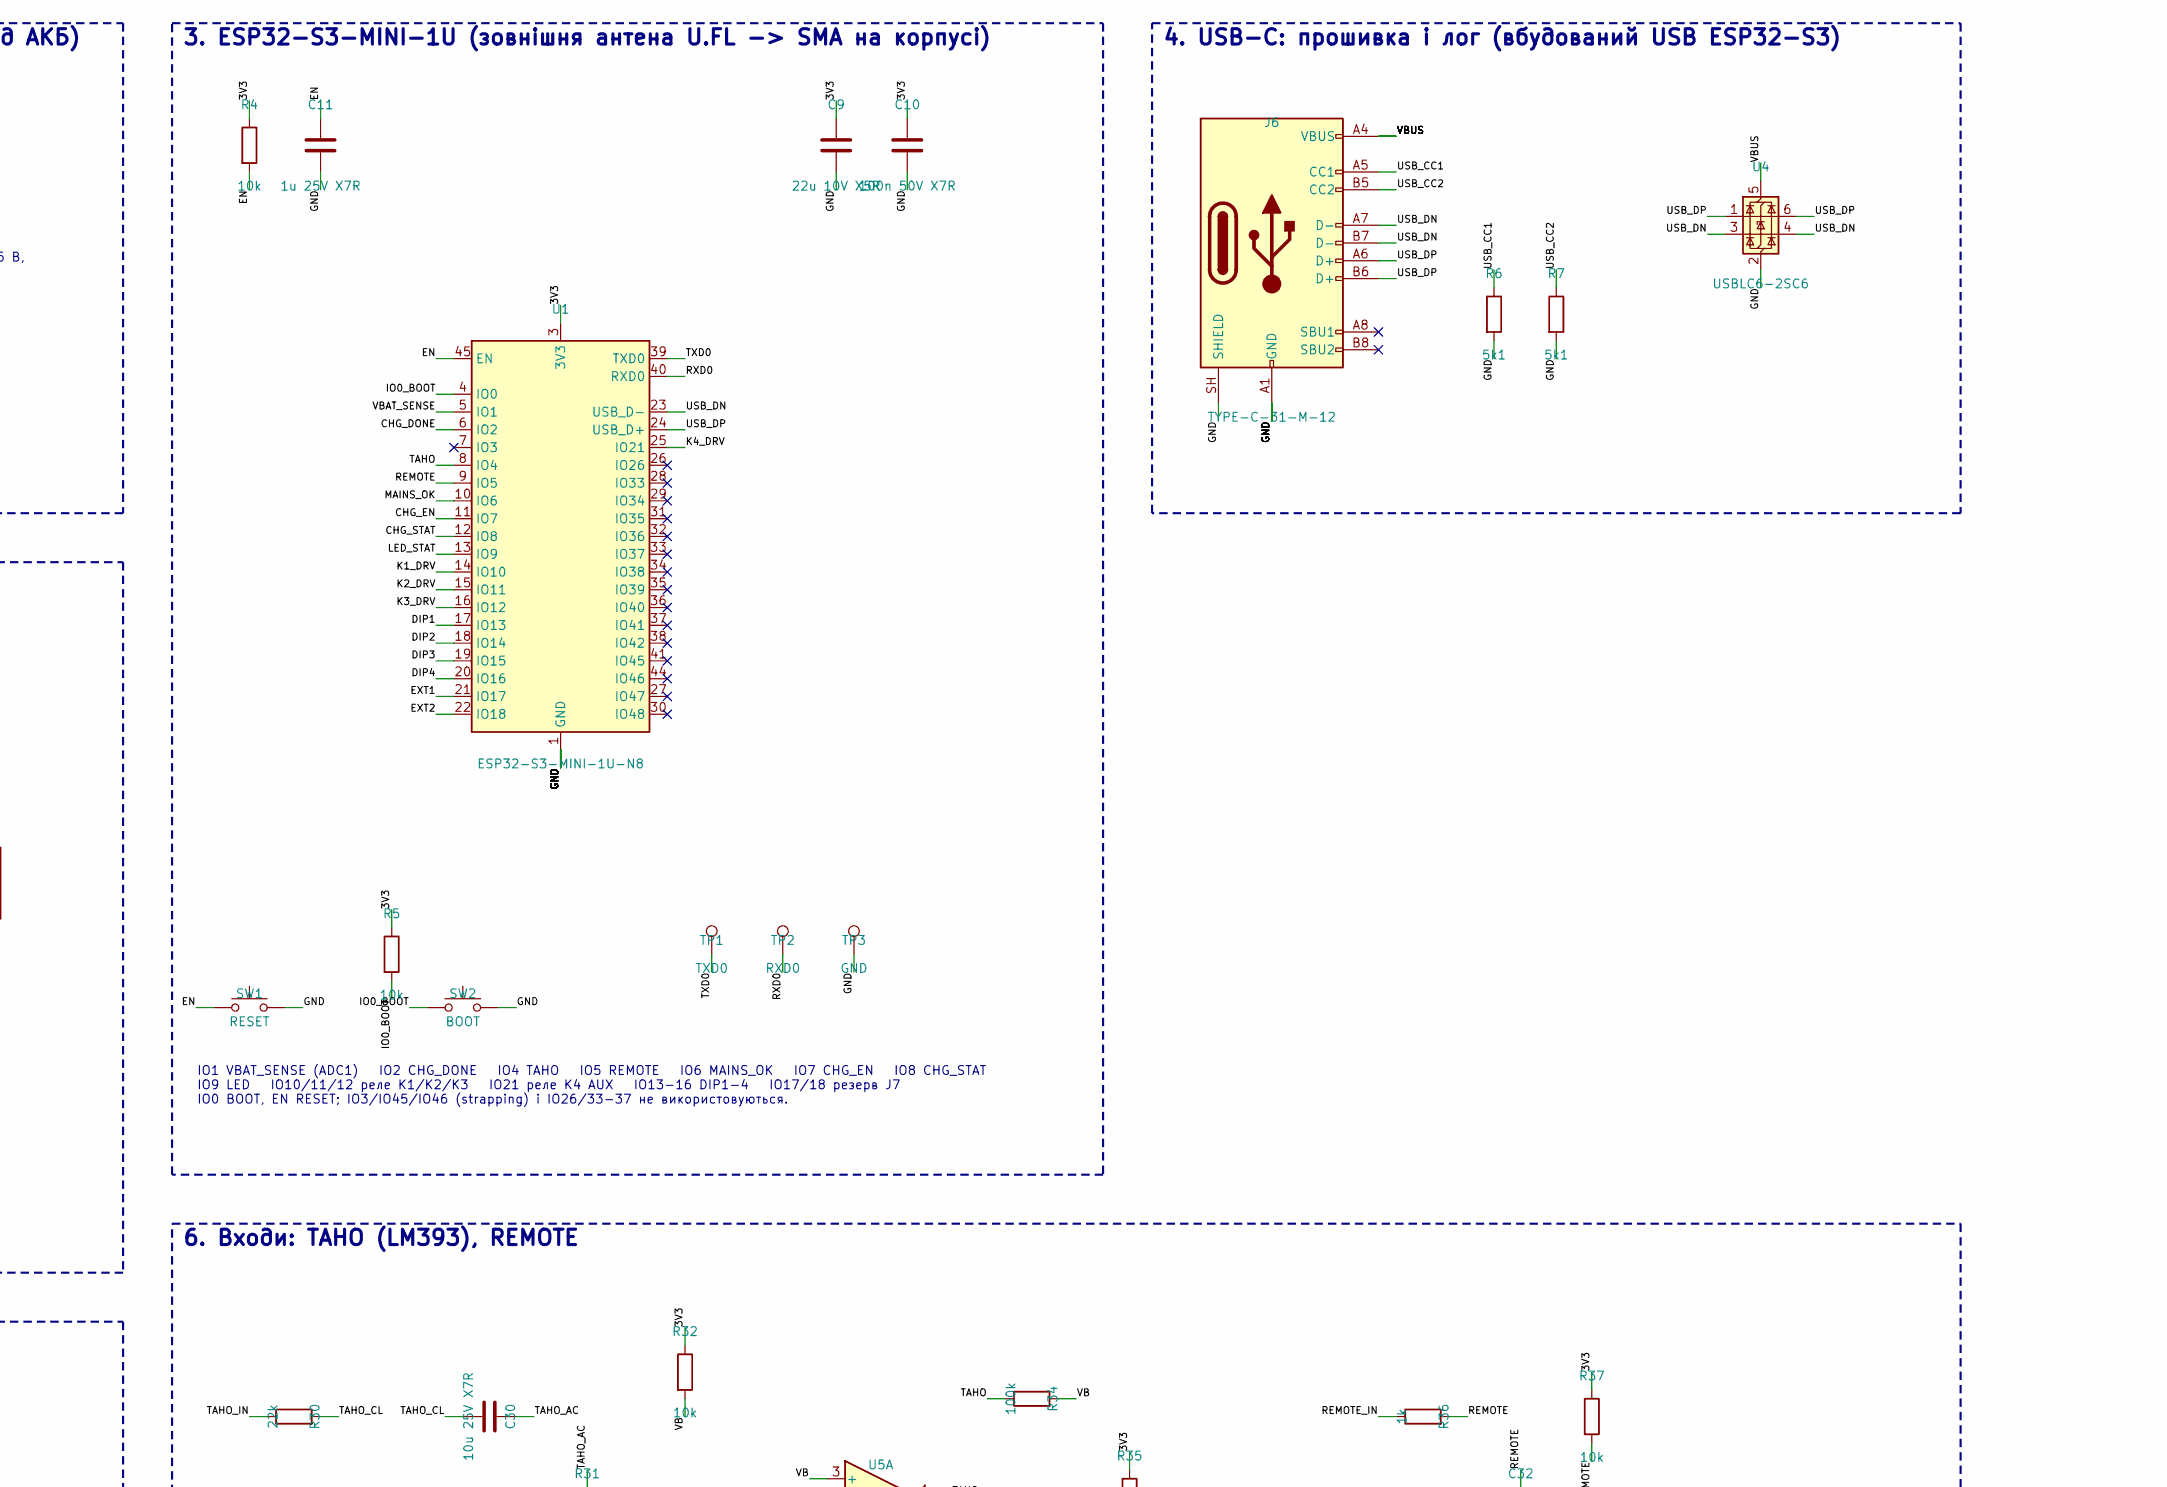
[picture p19: schematic pramac_v6.kicad_sch, Pramac PMD5050S autostart v6, part in row 1, column 2]

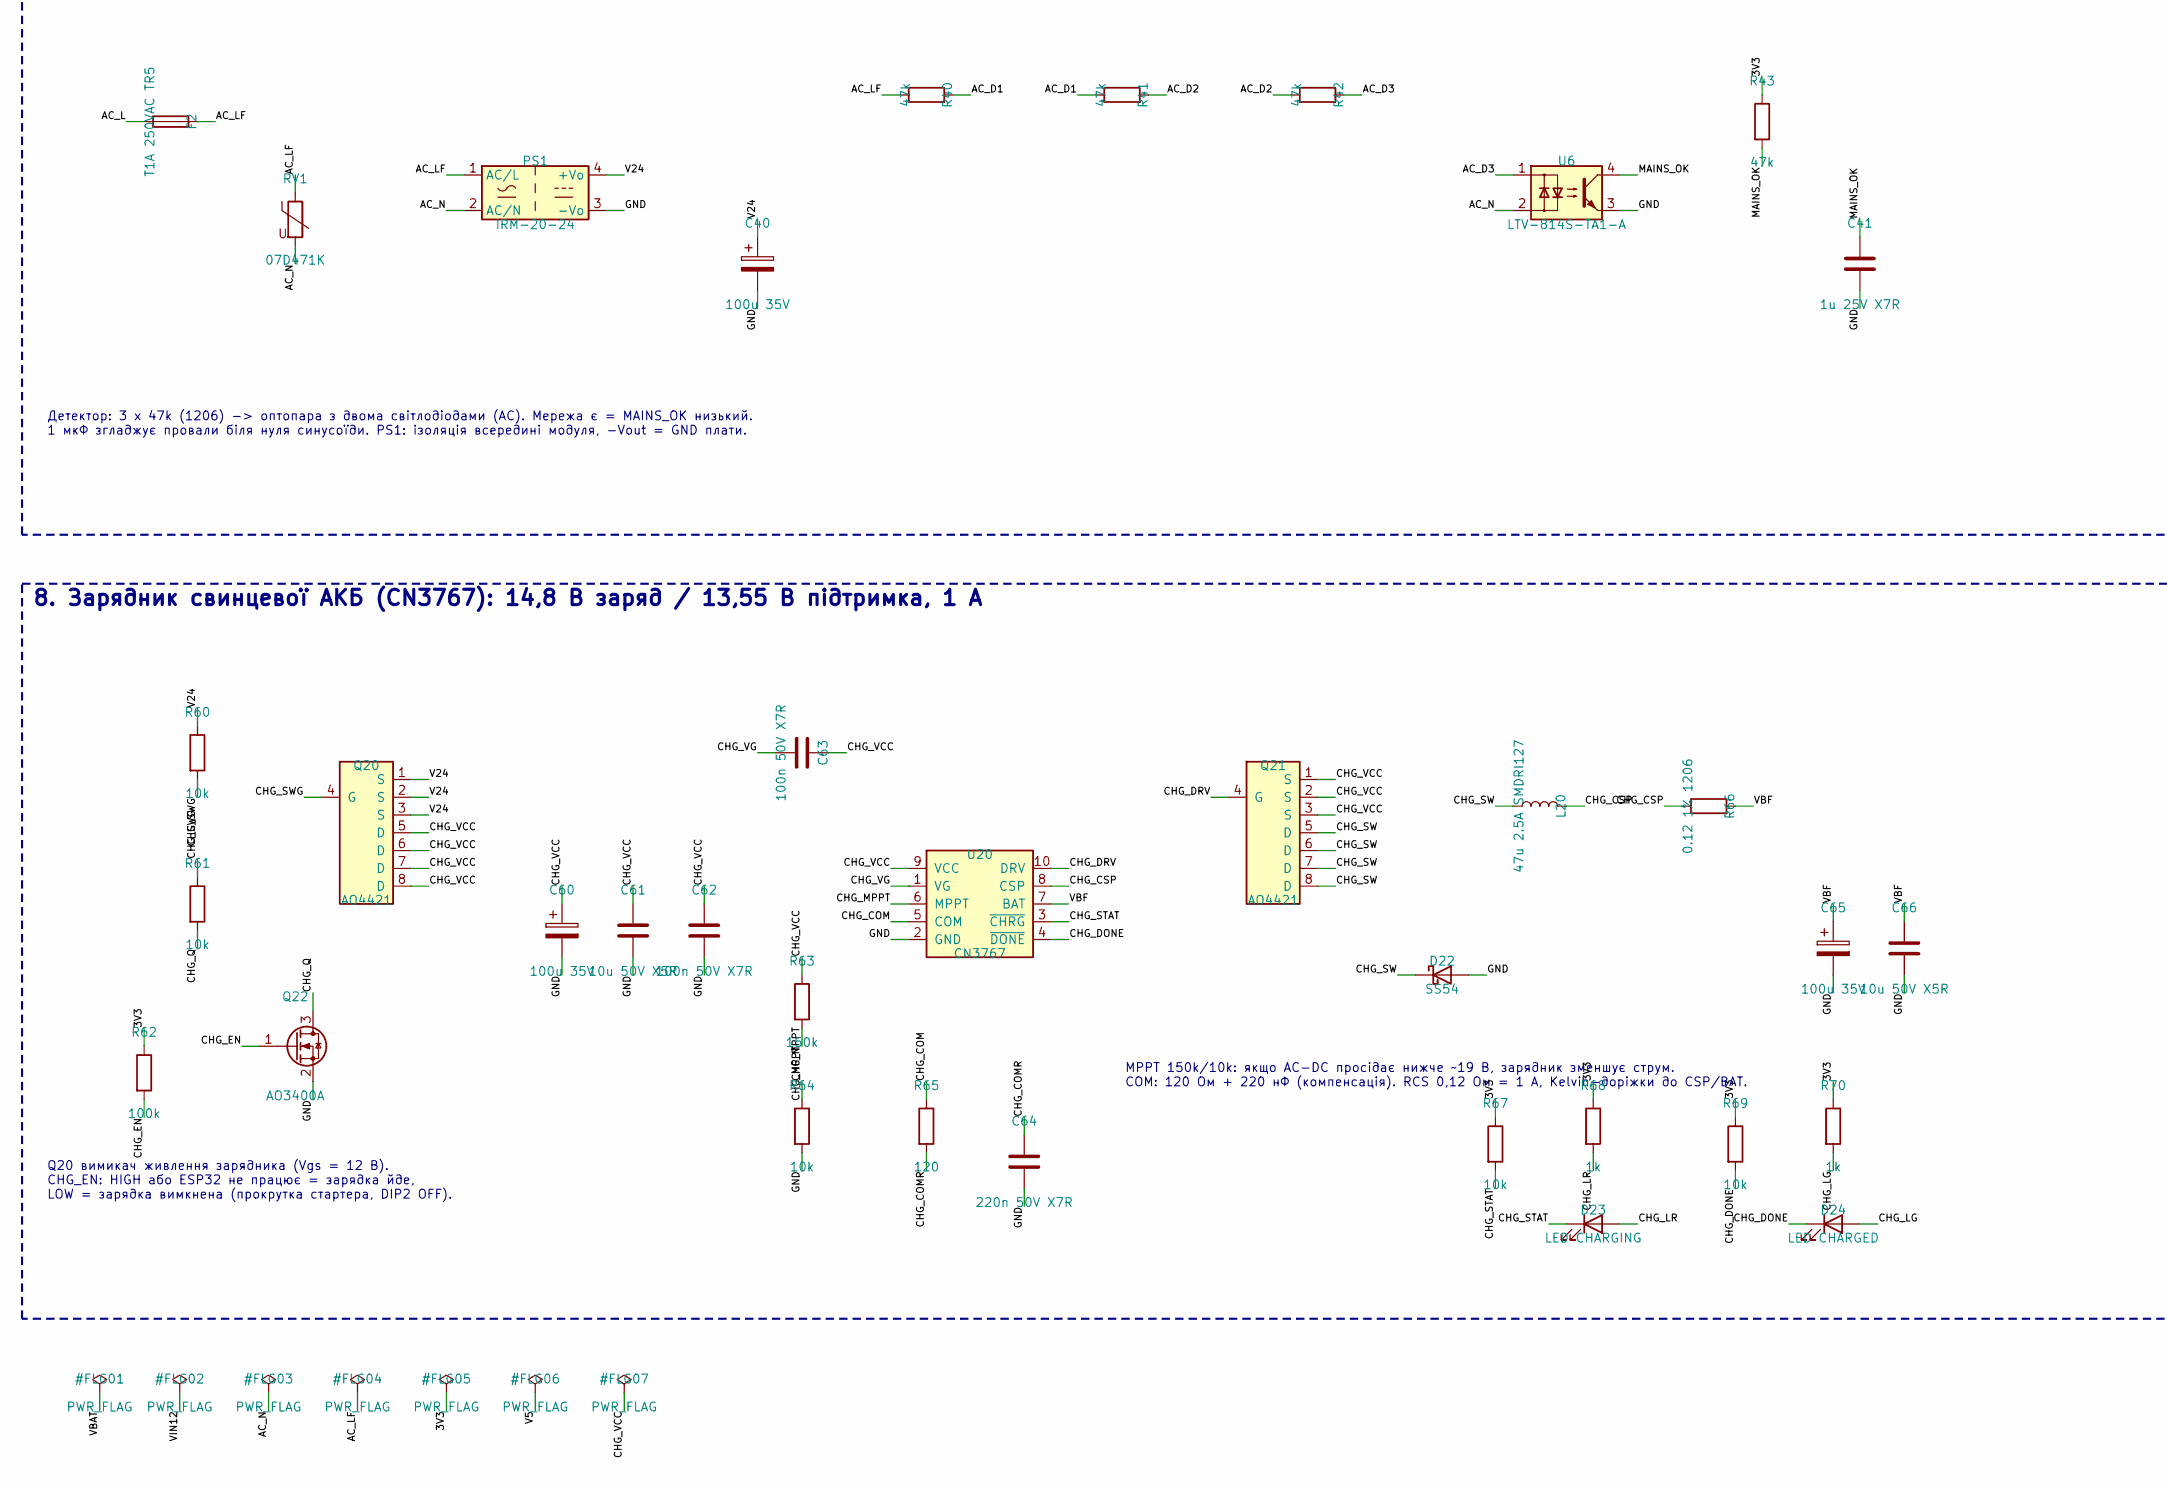
[picture p20: schematic pramac_v6.kicad_sch, Pramac PMD5050S autostart v6, part in row 2, column 1]

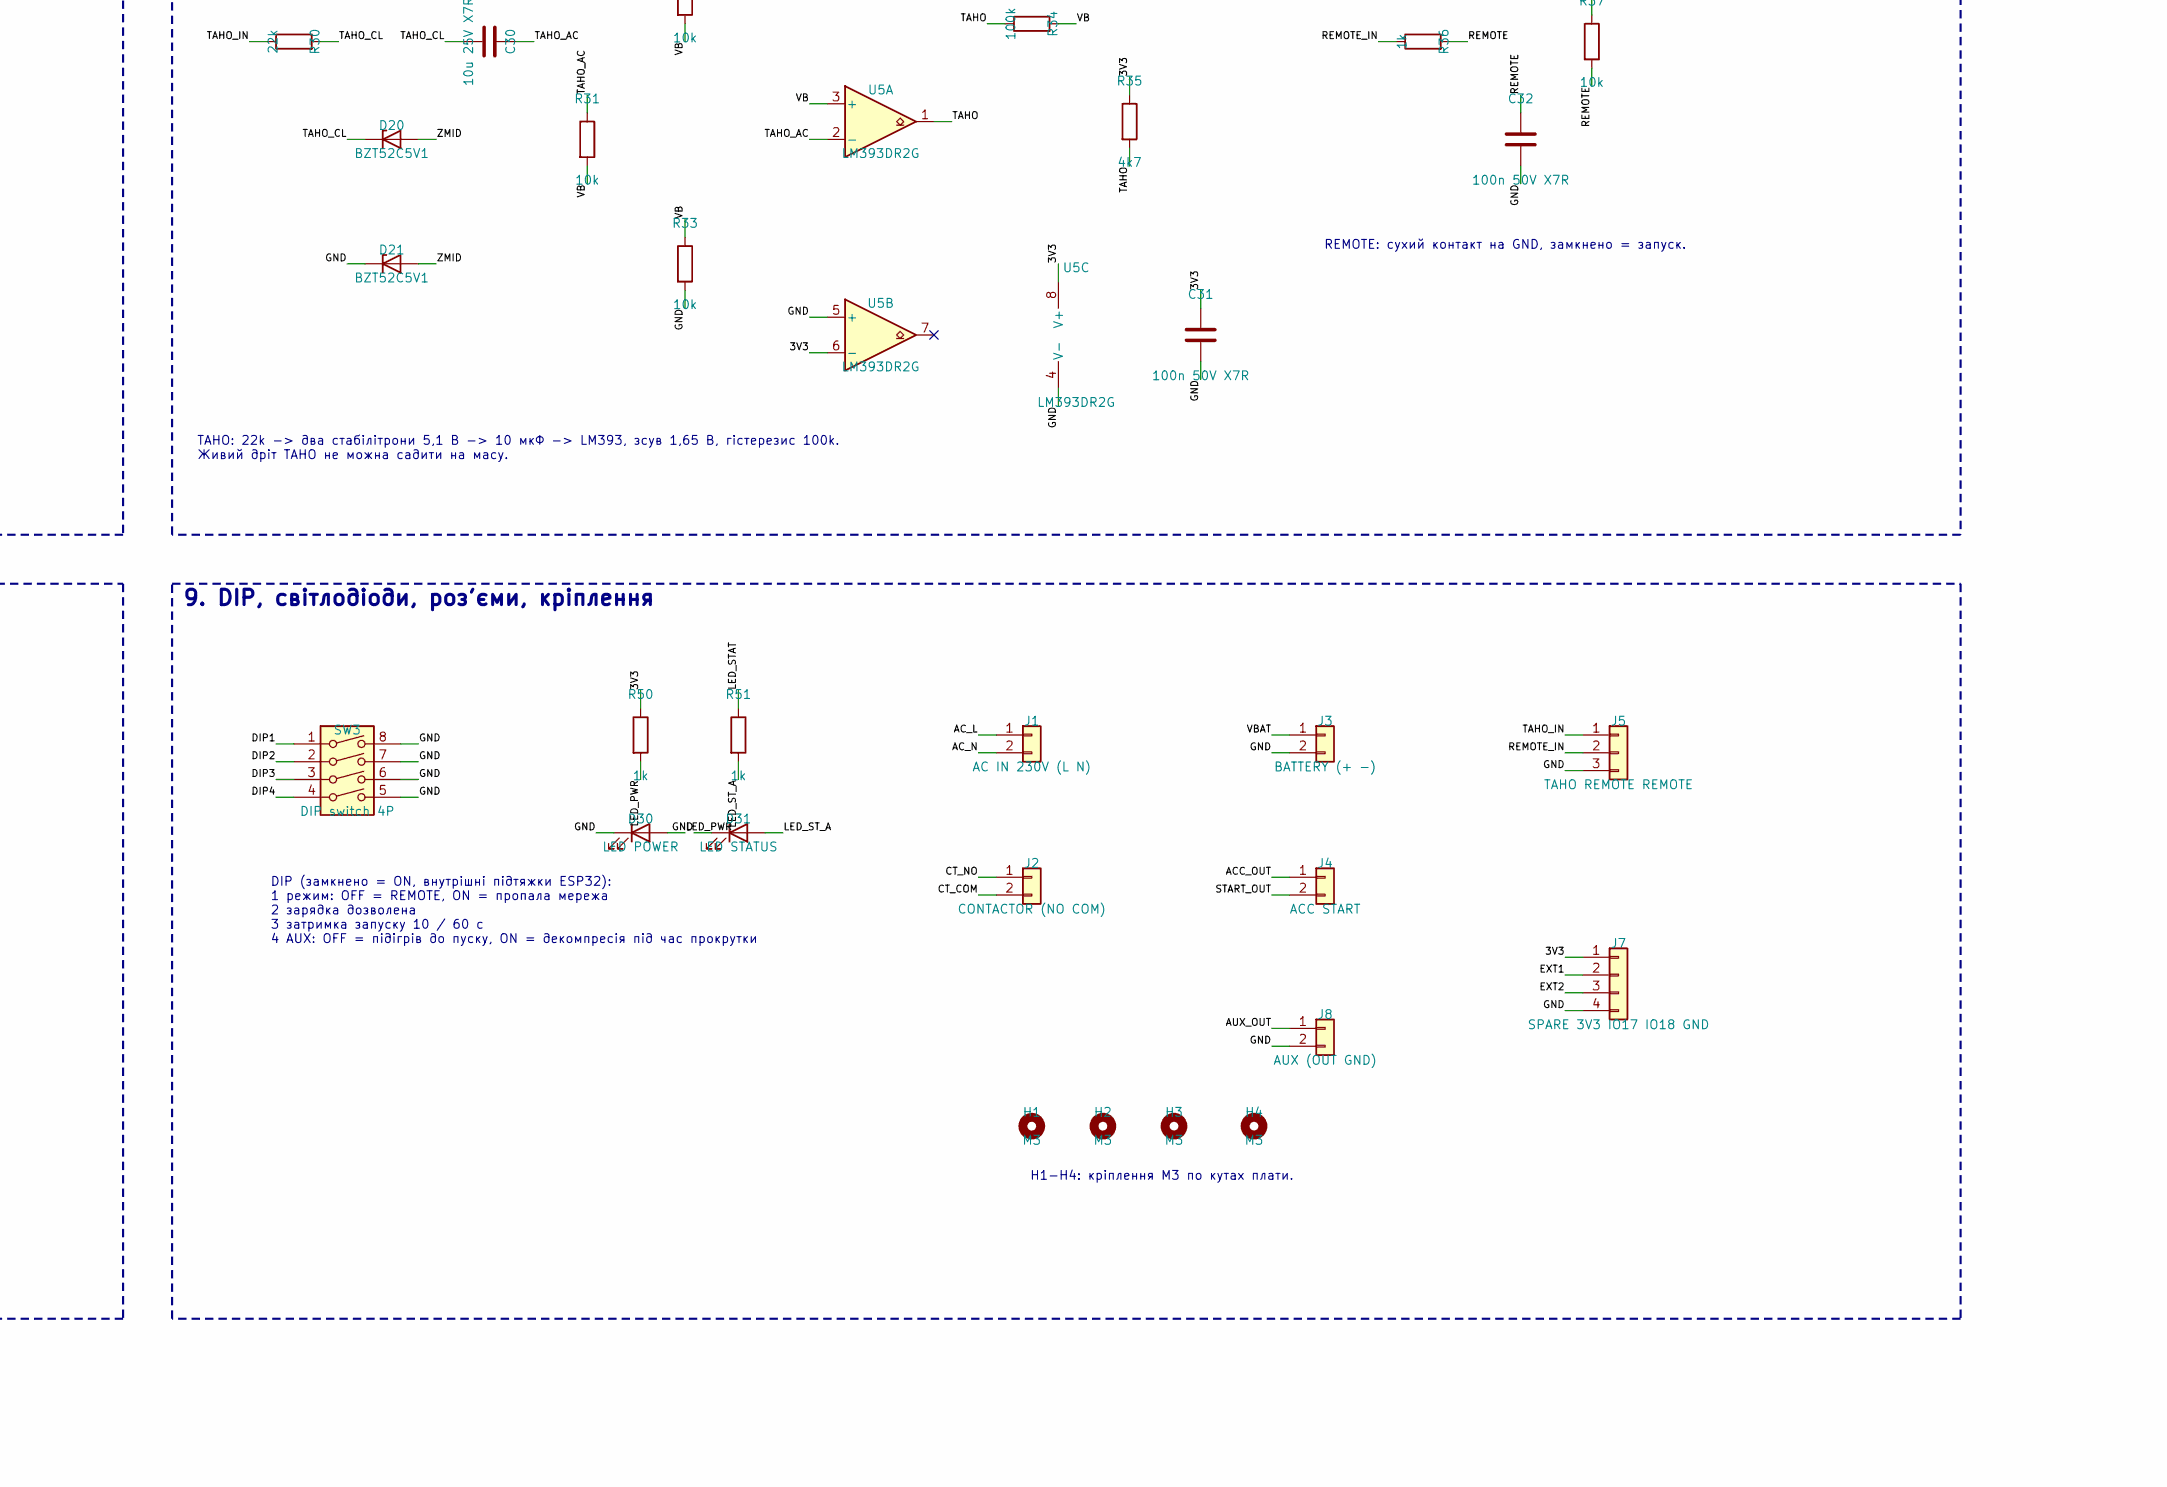
[picture p21: schematic pramac_v6.kicad_sch, Pramac PMD5050S autostart v6, part in row 2, column 2]

Parts:
C1: 470u 35V; CP_Elec_10x10.5; LCSC C2836436
C2, C13, C61, C66: 10u 50V X5R; C_1206_3216Metric; LCSC C13585
C3, C4, C7, C10, C31, C32, C62, C63: 100n 50V X7R; C_0805_2012Metric; LCSC C49678
C5, C6, C8, C9, C12: 22u 10V X5R; C_0805_2012Metric; LCSC C380338
C11, C41: 1u 25V X7R; C_0805_2012Metric; LCSC C89190
C30: 10u 25V X7R; C_1206_3216Metric; LCSC C70462
C40, C60, C65: 100u 35V; CP_Elec_6.3x7.7; LCSC C2836442
C64: 220n 50V X7R; C_0805_2012Metric; LCSC C5378
D1: SMBJ18A; D_SMB; LCSC C353379
D2, D22: SS54; D_SMA; LCSC C22452
D4: SS34; D_SMA; LCSC C8678
D10, D11, D12, D16: 1N4148W; D_SOD-123; LCSC C81598
D13: LED ACC; LED_0805_2012Metric; LCSC C84256
D14: LED START; LED_0805_2012Metric; LCSC C84256
D15: LED CONTACTOR; LED_0805_2012Metric; LCSC C84256
D17: LED AUX; LED_0805_2012Metric; LCSC C84256
D20, D21: BZT52C5V1; D_SOD-123; LCSC C2117
D23: LED CHARGING; LED_0805_2012Metric; LCSC C84256
D24: LED CHARGED; LED_0805_2012Metric; LCSC C2297
D30: LED POWER; LED_0805_2012Metric; LCSC C2297
D31: LED STATUS; LED_0805_2012Metric; LCSC C2297
F1: PTC 2A hold 1812; Fuse_1812_4532Metric; LCSC C434887
F2: T1A 250VAC TR5; Fuse_Littelfuse_372_D8.50mm; LCSC C142808
H1, H2, H3, H4: M3; MountingHole_3.2mm_M3
J1: AC IN 230V (L N); PhoenixContact_MSTBA_2,5_2-G-5,08_1x02_P5.08mm_Horizontal; LCSC C3697
J2: CONTACTOR (NO COM); PhoenixContact_MSTBA_2,5_2-G-5,08_1x02_P5.08mm_Horizontal; LCSC C3697
J3: BATTERY (+ -); PhoenixContact_MSTBA_2,5_2-G-5,08_1x02_P5.08mm_Horizontal; LCSC C3697
J4: ACC START; PhoenixContact_MSTBA_2,5_2-G-5,08_1x02_P5.08mm_Horizontal; LCSC C3697
J5: TAHO REMOTE REMOTE; PhoenixContact_MSTBA_2,5_3-G-5,08_1x03_P5.08mm_Horizontal; LCSC C8377
J6: TYPE-C-31-M-12; USB_C_Receptacle_HRO_TYPE-C-31-M-12; LCSC C165948
J7: SPARE 3V3 IO17 IO18 GND; PinHeader_1x04_P2.54mm_Vertical; LCSC C2691448
J8: AUX (OUT GND); PhoenixContact_MSTBA_2,5_2-G-5,08_1x02_P5.08mm_Horizontal; LCSC C3697
K1, K2, K3, K4: SRD-05VDC-SL-C; Relay_SPDT_SANYOU_SRD_Series_Form_C; LCSC C35449
L1, L2: 4.7u 5A FXL0530; L_Changjiang_FXL0530; LCSC C177246
L20: 47u 2.5A SMDRI127; L_12x12mm_H8mm; LCSC C9906
PS1: IRM-20-24; Converter_ACDC_MeanWell_IRM-20-xx_THT; LCSC C194964
Q1, Q2, Q3, Q4, Q22: AO3400A; SOT-23; LCSC C20917
Q20, Q21: AO4421; SOIC-8_3.9x4.9mm_P1.27mm; LCSC C33484
R1, R3, R8, R11, R13, R15, R17, R34, R62: 100k; R_0805_2012Metric; LCSC C149504
R2: 22k; R_0805_2012Metric; LCSC C17560
R4, R5, R31, R32, R33, R37, R60, R61, R64, R67, R69: 10k; R_0805_2012Metric; LCSC C17414
R6, R7: 5k1; R_0805_2012Metric; LCSC C27834
R10, R12, R14, R16: 100; R_0805_2012Metric; LCSC C17408
R20, R21, R22, R23: 2k2; R_0805_2012Metric; LCSC C17520
R30: 22k; R_1206_3216Metric; LCSC C25830
R35: 4k7; R_0805_2012Metric; LCSC C17673
R36, R50, R51, R68, R70: 1k; R_0805_2012Metric; LCSC C17513
R40, R41, R42: 47k; R_1206_3216Metric; LCSC C25833
R43: 47k; R_0805_2012Metric; LCSC C17713
R63: 150k; R_0805_2012Metric; LCSC C17470
R65: 120; R_0805_2012Metric; LCSC C17437
R66: 0.12 1% 1206; R_1206_3216Metric; LCSC C2907346
RV1: 07D471K; RV_Disc_D7mm_W3.4mm_P5mm; LCSC C28756
SW1: RESET; SW_Push_1P1T_XKB_TS-1187A; LCSC C318884
SW2: BOOT; SW_Push_1P1T_XKB_TS-1187A; LCSC C318884
SW3: DIP switch 4P; SW_DIP_SPSTx04_Slide_6.7x11.72mm_W8.61mm_P2.54mm_LowProfile; LCSC C6331176
TP1: TXD0; TestPoint_Pad_D1.5mm
TP2: RXD0; TestPoint_Pad_D1.5mm
TP3: GND; TestPoint_Pad_D1.5mm
U1: ESP32-S3-MINI-1U-N8; ESP32-S2-MINI-1U; LCSC C2980299
U2: AP63203WU-7; TSOT-23-6; LCSC C780769
U3: AP63205WU-7; TSOT-23-6; LCSC C2071056
U4: USBLC6-2SC6; SOT-23-6; LCSC C7519
U5: LM393DR2G; SOIC-8_3.9x4.9mm_P1.27mm; LCSC C7955
U6: LTV-814S-TA1-A; SMDIP-4_W9.53mm; LCSC C108051
U20: CN3767; SSOP-10_3.9x4.9mm_P1.00mm; LCSC C81968

Connections:
3V3: C5.1, C6.1, C9.1, C10.1, C31.1, J7.1, L1.2, R4.1, R5.1, R32.1, R35.1, R37.1, R43.1, R50.1, R62.1, R67.1, R68.1, R69.1, R70.1, U1.3 (3V3), U2.1 (FB), U5.6 (-), U5.8 (V+)
ACC_OUT: J4.1, K1.3
AC_D1: R40.2, R41.1
AC_D2: R41.2, R42.1
AC_D3: R42.2, U6.1
AC_L: F2.1, J1.1
AC_LF: F2.2, PS1.1 (AC/L), R40.1, RV1.1
AC_N: J1.2, PS1.2 (AC/N), RV1.2, U6.2
AUX_OUT: J8.1, K4.3
BUCK5_BST: C7.1, U3.6 (BST)
BUCK5_EN: R8.2, U3.2 (EN)
BUCK5_SW: C7.2, L2.1, U3.5 (SW)
BUCK_BST: C4.1, U2.6 (BST)
BUCK_EN: R3.2, U2.2 (EN)
BUCK_SW: C4.2, L1.1, U2.5 (SW)
CHG_COM: R65.1, U20.5 (COM)
CHG_COMR: C64.1, R65.2
CHG_CSP: L20.2, R66.1, U20.8 (CSP)
CHG_DONE: D24.1 (K), R69.2, U1.6 (IO2), U20.4 (~DONE)
CHG_DRV: Q21.4 (G), U20.10 (DRV)
CHG_EN: Q22.1 (G), R62.2, U1.11 (IO7)
CHG_LG: D24.2 (A), R70.2
CHG_LR: D23.2 (A), R68.2
CHG_MPPT: R63.2, R64.1, U20.6 (MPPT)
CHG_Q: Q22.3 (D), R61.2
CHG_STAT: D23.1 (K), R67.2, U1.12 (IO8), U20.3 (~CHRG)
CHG_SW: D22.1 (K), L20.1, Q21.5 (D), Q21.6 (D), Q21.7 (D), Q21.8 (D)
CHG_SWG: Q20.4 (G), R60.2, R61.1
CHG_VCC: C60.1, C61.1, C62.1, C63.2, Q20.5 (D), Q20.6 (D), Q20.7 (D), Q20.8 (D), Q21.1 (S), Q21.2 (S), Q21.3 (S), R63.1, U20.9 (VCC)
CHG_VG: C63.1, U20.1 (VG)
CT_COM: J2.2, K3.1
CT_NO: J2.1, K3.3
DIP1: SW3.1, U1.17 (IO13)
DIP2: SW3.2, U1.18 (IO14)
DIP3: SW3.3, U1.19 (IO15)
DIP4: SW3.4, U1.20 (IO16)
EN: C11.1, R4.2, SW1.1, U1.45 (EN)
EXT1: J7.2, U1.21 (IO17)
EXT2: J7.3, U1.22 (IO18)
GND: C1.2, C2.2, C3.2, C5.2, C6.2, C8.2, C9.2, C10.2, C11.2, C12.2, C13.2, C31.2, C32.2, C40.2, C41.2, C60.2, C61.2, C62.2, C64.2, C65.2, C66.2, D1.2 (A), D21.1 (K), D22.2 (A), D30.1 (K), D31.1 (K), J3.2, J5.3, J6.A1 (GND), J6.A12 (GND), J6.B1 (GND), J6.B12 (GND), J6.SH (SHIELD), J7.4, J8.2, PS1.3 (-Vo), Q1.2 (S), Q2.2 (S), Q3.2 (S), Q4.2 (S), Q22.2 (S), R2.2, R6.2, R7.2, R11.2, R13.2, R15.2, R17.2, R33.2, R64.2, SW1.2, SW2.2, SW3.5, SW3.6, SW3.7, SW3.8, TP3.1, U1.1 (GND), U1.2 (GND), U1.42 (GND), U1.43 (GND), U1.46 (GND), U1.47 (GND), U1.48 (GND), U1.49 (GND), U1.50 (GND), U1.51 (GND), U1.52 (GND), U1.53 (GND), U1.54 (GND), U1.55 (GND), U1.56 (GND), U1.57 (GND), U1.58 (GND), U1.59 (GND), U1.60 (GND), U1.61 (GND), U1.62 (GND), U1.63 (GND), U1.64 (GND), U1.65 (GND), U2.4 (GND), U3.4 (GND), U4.2 (GND), U5.4 (V-), U5.5 (+), U6.3, U20.2 (GND)
IO0_BOOT: R5.2, SW2.1, U1.4 (IO0)
K1_COIL: D10.2 (A), D13.1 (K), K1.5, Q1.3 (D)
K1_DRV: R10.1, U1.14 (IO10)
K1_G: Q1.1 (G), R10.2, R11.1
K1_LED: D13.2 (A), R20.2
K2_COIL: D11.2 (A), D14.1 (K), K2.5, Q2.3 (D)
K2_DRV: R12.1, U1.15 (IO11)
K2_G: Q2.1 (G), R12.2, R13.1
K2_LED: D14.2 (A), R21.2
K3_COIL: D12.2 (A), D15.1 (K), K3.5, Q3.3 (D)
K3_DRV: R14.1, U1.16 (IO12)
K3_G: Q3.1 (G), R14.2, R15.1
K3_LED: D15.2 (A), R22.2
K4_COIL: D16.2 (A), D17.1 (K), K4.5, Q4.3 (D)
K4_DRV: R16.1, U1.25 (IO21)
K4_G: Q4.1 (G), R16.2, R17.1
K4_LED: D17.2 (A), R23.2
LED_PWR: D30.2 (A), R50.2
LED_STAT: R51.1, U1.13 (IO9)
LED_ST_A: D31.2 (A), R51.2
MAINS_OK: C41.1, R43.2, U1.10 (IO6), U6.4
REMOTE: C32.1, R36.2, R37.2, U1.9 (IO5)
REMOTE_IN: J5.2, R36.1
RXD0: TP2.1, U1.40 (RXD0)
START_OUT: J4.2, K2.3
TAHO: R34.1, R35.2, U1.8 (IO4), U5.1
TAHO_AC: C30.2, R31.1, U5.2 (-)
TAHO_CL: C30.1, D20.1 (K), R30.2
TAHO_IN: J5.1, R30.1
TXD0: TP1.1, U1.39 (TXD0)
USB_CC1: J6.A5 (CC1), R6.1
USB_CC2: J6.B5 (CC2), R7.1
USB_DN: J6.A7 (D-), J6.B7 (D-), U1.23 (USB_D-), U4.3 (I/O2), U4.4 (I/O2)
USB_DP: J6.A6 (D+), J6.B6 (D+), U1.24 (USB_D+), U4.1 (I/O1), U4.6 (I/O1)
V5: C8.1, C12.1, D10.1 (K), D11.1 (K), D12.1 (K), D16.1 (K), K1.2, K2.2, K3.2, K4.2, L2.2, R20.1, R21.1, R22.1, R23.1, U3.1 (FB)
V24: C40.1, PS1.4 (+Vo), Q20.1 (S), Q20.2 (S), Q20.3 (S), R60.1
VB: R31.2, R32.2, R33.1, R34.2, U5.3 (+)
VBAT: F1.1, J3.1, K1.1, K2.1, K4.1
VBAT_SENSE: C3.1, R1.2, R2.1, U1.5 (IO1)
VBF: C65.1, C66.1, D1.1 (K), D2.2 (A), F1.2, R1.1, R66.2, U20.7 (BAT)
VBUS: D4.2 (A), J6.A4 (VBUS), J6.A9 (VBUS), J6.B4 (VBUS), J6.B9 (VBUS), U4.5 (VBUS)
VIN12: C1.1, C2.1, C13.1, D2.1 (K), D4.1 (K), R3.1, R8.1, U2.3 (IN), U3.3 (IN)
ZMID: D20.2 (A), D21.2 (A)

Notes on the sheet:
1. Вхід 12 В: запобіжник, TVS, захист від переплутаної полярності
Шина VBAT (до запобіжника) іде на COM реле K1/K2/K4 широкою доріжкою. На дроті від АКБ потрібен зовнішній запобіжник ~15 А. VBAT_SENSE: 15,5 В -> 2,8 В на АЦП (дільник 100k/22k).
2. Живлення: 3,3 В для ESP32 і окремі 5 В для котушок реле (обидва buck прямо від АКБ)
Режим LDO AP6320x: коли АКБ < 5 В, вихід 5 В іде слідом за входом; SRD-05 тримається до ~2 В. ESP32 працює від АКБ 3,8 В. Іоністор не потрібен. D4: живлення від USB.
3. ESP32-S3-MINI-1U (зовнішня антена U.FL -> SMA на корпусі)
IO1 VBAT_SENSE (ADC1) IO2 CHG_DONE IO4 TAHO IO5 REMOTE IO6 MAINS_OK IO7 CHG_EN IO8 CHG_STAT IO9 LED IO10/11/12 реле K1/K2/K3 IO21 реле K4 AUX IO13-16 DIP1-4 IO17/18 резерв J7 IO0 BOOT, EN RESET; IO3/IO45/IO46 (strapping) і IO26/33-37 не використовуються.
4. USB-C: прошивка і лог (вбудований USB ESP32-S3)
5. Реле: K1 ACC, K2 START, K4 AUX (COM = VBAT), K3 контактор (сухі контакти 230 В)
Реле SRD-05VDC: котушка 5 В / 72 мА від окремого buck 5 В, ключ AO3400A, діод на котушці, світлодіод стану. Затвор притягнутий до GND (100k): поки ESP32 завантажується, реле вимкнені.
6. Входи: TAHO (LM393), REMOTE
TAHO: 22k -> два стабілітрони 5,1 В -> 10 мкФ -> LM393, зсув 1,65 В, гістерезис 100k. Живий дріт TAHO не можна садити на масу.
REMOTE: сухий контакт на GND, замкнено = запуск.
7. 230 В: запобіжник, варистор, AC-DC 24 В, детектор мережі (зазор >= 8 мм до низьковольтної частини)
Детектор: 3 x 47k (1206) -> оптопара з двома світлодіодами (AC). Мережа є = MAINS_OK низький. 1 мкФ згладжує провали біля нуля синусоїди. PS1: ізоляція всередині модуля, -Vout = GND плати.
8. Зарядник свинцевої АКБ (CN3767): 14,8 В заряд / 13,55 В підтримка, 1 А
Q20 вимикач живлення зарядника (Vgs = 12 В). CHG_EN: HIGH або ESP32 не працює = зарядка йде, LOW = зарядка вимкнена (прокрутка стартера, DIP2 OFF).
MPPT 150k/10k: якщо AC-DC просідає нижче ~19 В, зарядник зменшує струм. COM: 120 Ом + 220 нФ (компенсація). RCS 0,12 Ом = 1 А, Kelvin-доріжки до CSP/BAT.
9. DIP, світлодіоди, роз'єми, кріплення
DIP (замкнено = ON, внутрішні підтяжки ESP32): 1 режим: OFF = REMOTE, ON = пропала мережа 2 зарядка дозволена 3 затримка запуску 10 / 60 с 4 AUX: OFF = підігрів до пуску, ON = декомпресія під час прокрутки
H1-H4: кріплення M3 по кутах плати.

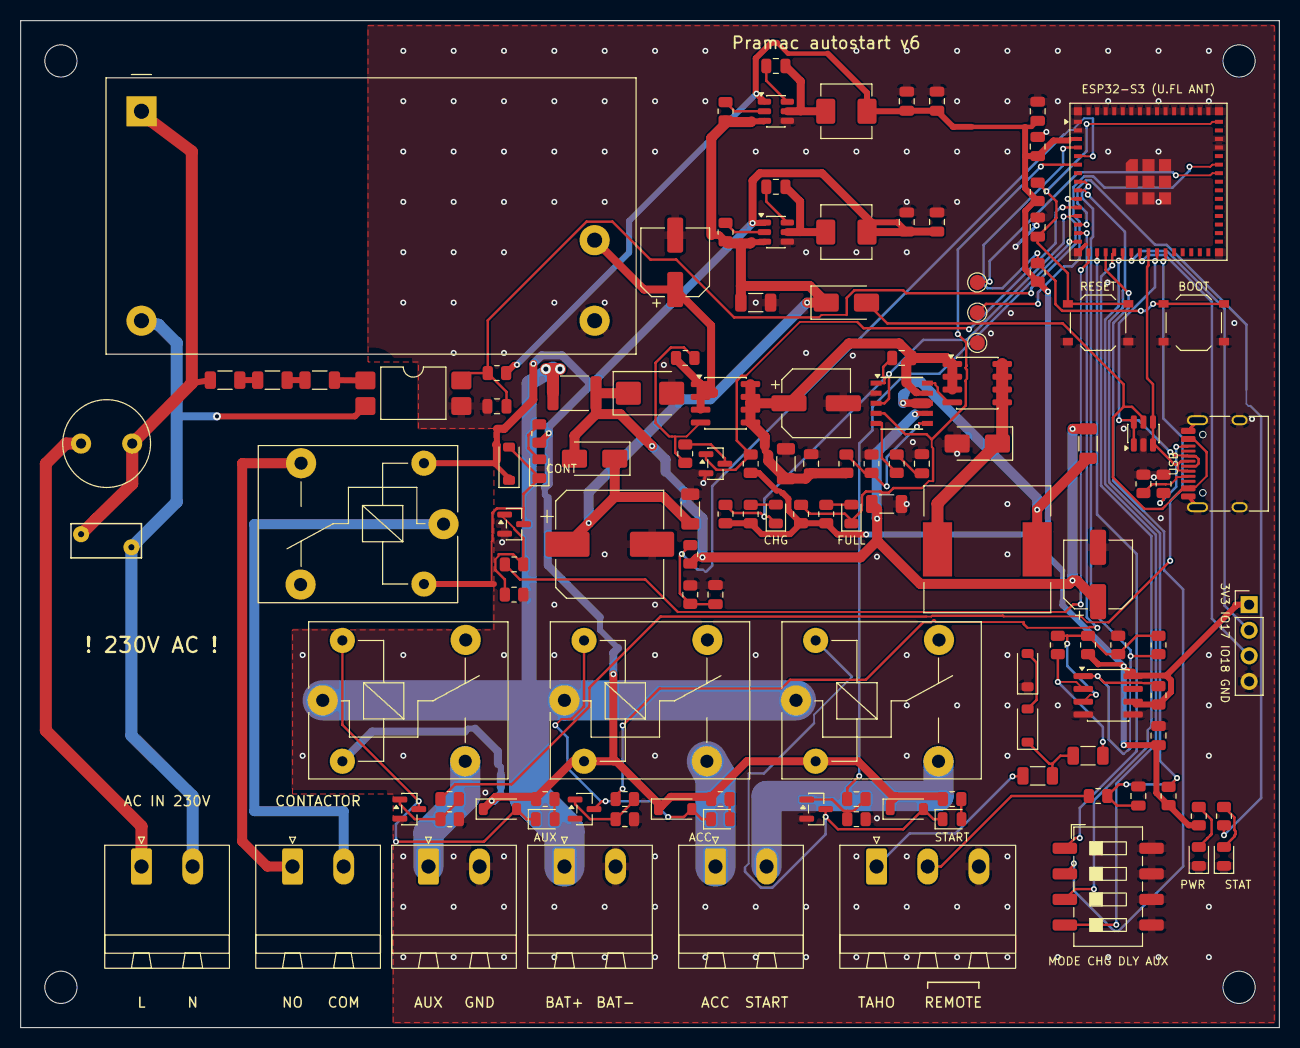
[picture p22: board pramac_v6.kicad_pcb from above]

Board: 2 copper layers, 125.0 x 100.0 mm, 131 parts (0 on the bottom side), 83 nets.
