4106677/pramac-pmd5050s-autostart/hardware/pramac_carrier.kicad_pcb

## KiCad design hardware/pramac_carrier.kicad_pcb (2026-11-11)

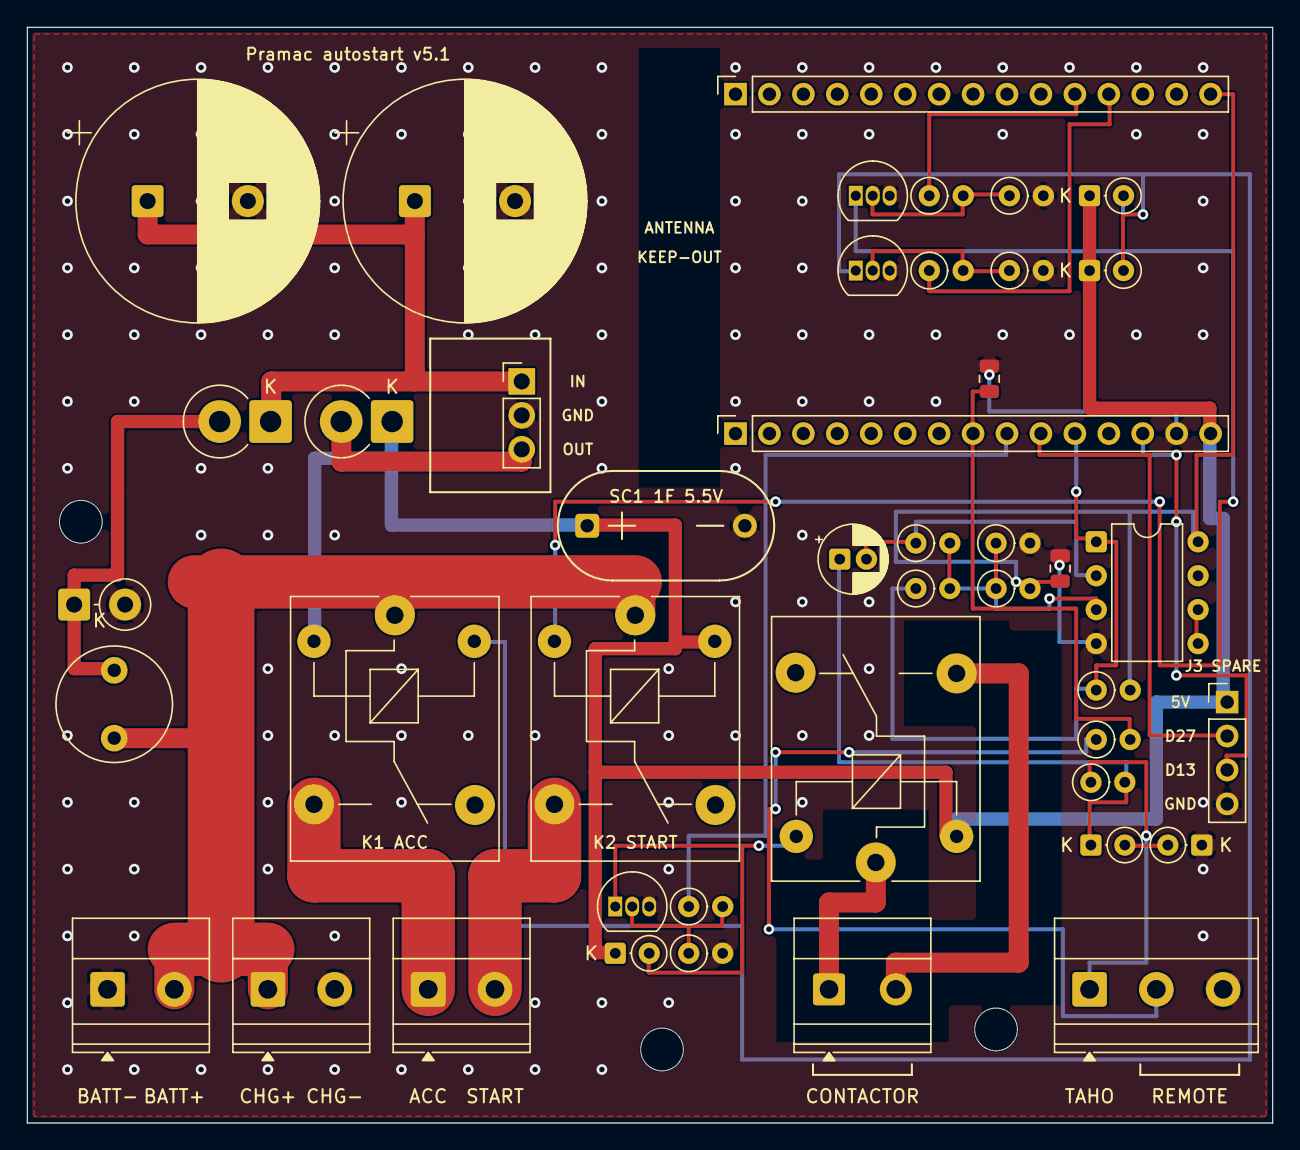
[picture p23: board pramac_carrier.kicad_pcb from above]

Board: 2 copper layers, 93.2 x 82.0 mm, 47 parts (0 on the bottom side), 31 nets.

Parts:
C1, C2: 4700u 25V; CP_Radial_D18.0mm_P7.50mm
C3: 10u 16V NP; CP_Radial_D5.0mm_P2.00mm
C5, C6: 100n; C_0805_2012Metric
D1, D2: 1N5821; D_DO-201AD_P3.81mm_Vertical_CathodeUp
D3: P6KE36A (P6KE20A recommended); D_DO-15_P3.81mm_Vertical_CathodeUp
D4, D5: BZX55C5V1; D_DO-35_SOD27_P2.54mm_Vertical_CathodeUp
D6, D7, D8: 1N4148; D_DO-35_SOD27_P2.54mm_Vertical_CathodeUp
F1: KLS5-102-5RT-020H 2A slow; Fuse_Littelfuse_372_D8.50mm
H1, H2, H3: M3; MountingHole_3.2mm_M3
J1: BATT- / BATT+; TerminalBlock_Phoenix_MKDS-1,5-2_1x02_P5.00mm_Horizontal
J2: TAHO / REMOTE; TerminalBlock_Phoenix_MKDS-1,5-3_1x03_P5.00mm_Horizontal
J3: Spare relay module 5V/IN1(D27)/IN2(D13)/GND; PinHeader_1x04_P2.54mm_Vertical
J4: CHARGER +12V / GND; TerminalBlock_Phoenix_MKDS-1,5-2_1x02_P5.00mm_Horizontal
J5: ACC OUT / START OUT (relay NO); TerminalBlock_Phoenix_MKDS-1,5-2_1x02_P5.00mm_Horizontal
J6: CONTACTOR (relay K3 dry COM/NO, 230V); TerminalBlock_Phoenix_MKDS-1,5-2_1x02_P5.00mm_Horizontal
K1: SRD-05VDC-SL-A ACC; Relay_SPDT_SANYOU_SRD_Series_Form_C
K2: SRD-05VDC-SL-A START; Relay_SPDT_SANYOU_SRD_Series_Form_C
K3: SRD-05VDC-SL-A CONTACTOR; Relay_SPDT_SANYOU_SRD_Series_Form_C
Q1, Q2, Q3: BC337; TO-92_Inline
R1: 22k; R_Axial_DIN0207_L6.3mm_D2.5mm_P2.54mm_Vertical
R4: 100k; R_Axial_DIN0207_L6.3mm_D2.5mm_P2.54mm_Vertical
R5: 4.7k; R_Axial_DIN0207_L6.3mm_D2.5mm_P2.54mm_Vertical
R6: 1k; R_Axial_DIN0207_L6.3mm_D2.5mm_P2.54mm_Vertical
RM1: Favotek RM20S-050 SIP-3: 1 +VIN, 2 GND, 3 +VOUT; PinHeader_1x03_P2.54mm_Vertical
Rb1, Rb2: 1k; R_Axial_DIN0207_L6.3mm_D2.5mm_P2.54mm_Vertical
Rb3: 10k; R_Axial_DIN0207_L6.3mm_D2.5mm_P2.54mm_Vertical
Rg3: 1k; R_Axial_DIN0207_L6.3mm_D2.5mm_P2.54mm_Vertical
Rp1, Rp2, Rp3: 10k; R_Axial_DIN0207_L6.3mm_D2.5mm_P2.54mm_Vertical
Rv1, Rv2: 10k; R_Axial_DIN0207_L6.3mm_D2.5mm_P2.54mm_Vertical
SC1: JEC SMD05R5S0001DARZ 1F 5.5V; CP_Radial_D5.0mm_P2.00mm
U1A: ESP32 bottom row; PinSocket_1x15_P2.54mm_Vertical
U1B: ESP32 top row; PinSocket_1x15_P2.54mm_Vertical
U3: LM393 (soldered, no socket); DIP-8_W7.62mm

Connections:
3V3: C5.1, R5.2, Rv1.2, U1B.15, U3.8
ACC: Rb1.1, U1B.12
ACC_OUT: J5.1, K1.3
BASE_ACC: Q1.2, Rb1.2, Rp1.1
BASE_CONT: Q3.2, Rg3.2, Rp3.1
BASE_START: Q2.2, Rb2.2, Rp2.1
CMP_OUT: R4.1, R5.1, U1A.11, U3.1
COIL_ACC: D6.2, K1.5, Q1.1
COIL_CONT: D8.2, K3.5, Q3.1
COIL_START: D7.2, K2.2, Q2.1
CONT: Rg3.1, U1A.9
CONTACT: J2.2, R6.1
CT_COM: J6.1, K3.1
CT_NO: J6.2, K3.3
D25: C6.1, R6.2, U1A.8
EXT1: J3.2, U1A.10
EXT2: J3.3, U1A.13
GND: C1.2, C2.2, C5.2, C6.2, D3.2, D5.1, J1.1, J2.3, J3.4, J4.2, Q1.3, Q2.3, Q3.3, RM1.2, Rp1.2, Rp2.2, Rp3.2, Rv2.2, SC1.2, U1A.14, U3.4
NODE_A: C1.1, C2.1, D1.1, RM1.1
NODE_B: D2.1, D6.1, D7.1, D8.1, J3.1, K1.2, K2.5, K3.2, SC1.1, U1A.15
START: Rb2.1, U1B.11
START_OUT: J5.2, K2.3
TAHO_AC: C3.2, Rb3.1, U3.2
TAHO_CL: C3.1, D4.1, R1.2
TAHO_IN: J2.1, R1.1
UNUSED_IN: U3.5, U3.6
VB: R4.2, Rb3.2, Rv1.1, Rv2.1, U3.3
VBATT: F1.1, J1.2, J4.1, K1.1, K2.1
VBF: D1.2, D3.1, F1.2
VBUCK: D2.2, RM1.3
ZMID: D4.2, D5.2
