4106677/pramac-pmd5050s-autostart/(commit log)

2026-10-07 Pramac PMD5050S autostart on ESP32 (ESPHome)
2026-10-07 Add KiCad carrier board (Gerbers, fit check, generator) and README section
    [pramac_carrier.kicad_pcb]
2026-10-12 Board v3: on-board relays with NPN drivers, RM20S DC-DC, charger input, one-side terminals, full BOM
    [pramac_carrier.kicad_pcb]
2026-10-12 Board v4: contactor relay K3, radial fuse, per-pin silk labels, QR/GitHub mark on back; firmware: contactor warm-up/cool-down logic
    [pramac_carrier.kicad_pcb]
2026-10-12 Board v4: shift VBATT/relay assembly left, board 118x94 mm
    [pramac_carrier.kicad_pcb]
2026-10-12 Board v5: minimal size 93.2x82 mm (horizontal ESP32, parts under module, antenna keep-out)
    [pramac_carrier.kicad_pcb]
2026-10-12 Rewrite README for board v5
2026-10-12 Gerbers: separate PTH/NPTH drill files
2026-10-12 Add 3D-printable enclosure (STL, Fusion parametric script, generator)
2026-10-12 Enclosure: add STL, Fusion script, generator and previews
    [base.stl, cover.stl, lid.stl]
2026-10-12 Add enclosure preview renderer
2026-10-12 Enclosure v2: rounded corners, chamfers, lid skirt over base rebate, flush cover pocket with hazard emblem
    [base.stl, cover.stl, lid.stl]
2026-10-12 Enclosure: cover no longer overlaps lid corner screws; emblem fits inside the cover
    [cover.stl, lid.stl]
2026-10-22 Enclosure v3: screwless glued cover with recessed SVG logo and hazard emblems, PCB support posts, ledges and guide fins
    [base.stl, cover.stl, lid.stl]
2026-10-22 Enclosure: Pramac logo recessed on the main lid, single hazard emblem on the cover
    [cover.stl, lid.stl]
2026-10-22 Enclosure: through window with glue ledge for the cover, removable wall-mount ears with captive nuts
    [base.stl, ear.stl, lid.stl]
2026-10-22 Enclosure: screwless wedge-fit trapezoid ears
    [base.stl, ear.stl]
2026-10-22 Enclosure: restore M3 insert holes in the base corner posts
    [base.stl]
2026-10-22 Enclosure: screw relief bores under the brass inserts for long screws
    [base.stl]
2026-11-11 Enclosure: fix the Fusion script after the first real run in Fusion
    - Sketch dimensions: Fusion rejects an origin dimension to a point that
    shares x/y with an already fixed point (OVER_CONSTRAINTS); tie it to
    that point with a vertical/horizontal constraint instead.
    - Bottom/top chamfers: use the outward face normal (plane geometry
    normal can be flipped), only the outer loop of the largest face, so
    pockets, screw recesses and the logo letter islands are left alone.
    - Bottom chamfer runs before the ear rebates notch the outline.
    - Cavity corner fillets: pick the vertical edges by position, they are
    split at the rebate step height.
    - Logo: imported SVG curves are fixed, so scale/posi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
    [fusion_enclosure.py]
2026-11-11 Enclosure: Fusion script for the PCB assembly, fasteners and colours
    fusion_pcb_assembly.py adds the v5 board with its components to the
    Fusion enclosure model, positioned from the KiCad footprints, plus brass
    M3 inserts and ISO 7380 M3x8 screws for the PCB and the lid. It colours
    the enclosure: white ABS, red cover insert and Pramac logo. Bodies are
    grouped into 'PCB asm: ...' base features because a Part Design document
    cannot hold sub-components; re-running the script replaces them.
    [fusion_pcb_assembly.py]
2026-11-11 Board v5.1: supercap footprint, RM20S silk fix, power parts re-placed
    - SC1: real footprint for the JEC 1 F 5.5 V can (16 x 8 mm, lead pitch 11.8)
    between the ESP32 and K1/K2; ESP32 sockets 2 mm higher, VBATT relay bus
    lowered and narrowed to 4 mm to make room
    - RM20S-050: body outline on the D2 side (v5 drew it on the wrong side, so
    the module went in backwards) and IN / GND / OUT labels; netlist unchanged
    - D1/D2 moved left to clear the RM20S body, D3 below H1, F1 below D3,
    back-side QR code lower and slightly smaller
    - relay labels moved below the relays; routing seed 16 is the default
    - gerbers, fit-check PDF, renders, BOM and README updated
    - enclosure: three 8 mm round-ended wi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
    [pramac_carrier.kicad_pcb]
2026-11-11 Firmware: 20 s cool-down after the contactor opens, relay test config
    - cooldown_s 3 -> 20: on STOP the contactor opens, the engine runs 20 s
    without load, then ACC is removed
    - esphome/relay-test.yaml: board check firmware (K1 clicks once, K2 twice,
    K3 three times with 3 s pauses, in a loop; logs REMOTE and TAHO), no Wi-Fi
    - esphome/.gitignore: build dir, secrets, local genset.yaml with device keys
2026-11-11 Home Assistant: card for the second generator (genset, board v5.1)
2026-11-12 Board v6: ESP32-S3 on board, AC charger, 4 relays incl. AUX, JLCPCB assembly files
    125 x 100 mm, 2 layers, separate 230 V zone with a 2.5 mm DRC rule.
    ESP32-S3-MINI-1U with U.FL, USB-C, AP63203/AP63205 bucks, 5 V SRD relays
    (ACC, START, AUX for heater or decompression, contactor), CN3767 lead-acid
    charger from IRM-20-24, mains detector, DIP mode switch, corner M3 holes.
    Gerbers, BOM and CPL for full factory assembly.
    [pramac_v6.dsn, pramac_v6.kicad_pcb, pramac_v6.kicad_sch, pramac_v6_bom.csv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]
